frohro/Raspberry_Pi_Pico_MultiBoard/Hardware/Download_STEP_150505M173300_rev1.stp

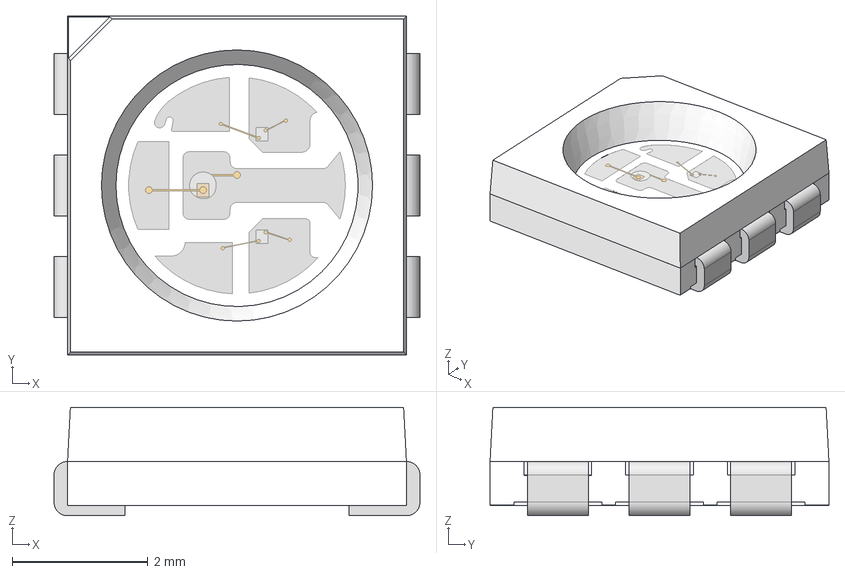
[picture p1: CAD file, 2025-04-10]
Hardware/Download_STEP_150505M173300_rev1.stp
5.40 x 5.00 x 1.60 mm
cover
housing
base x 2
