frohro/Raspberry_Pi_Pico_MultiBoard/Hardware/Amphenol RF 122404.STEP

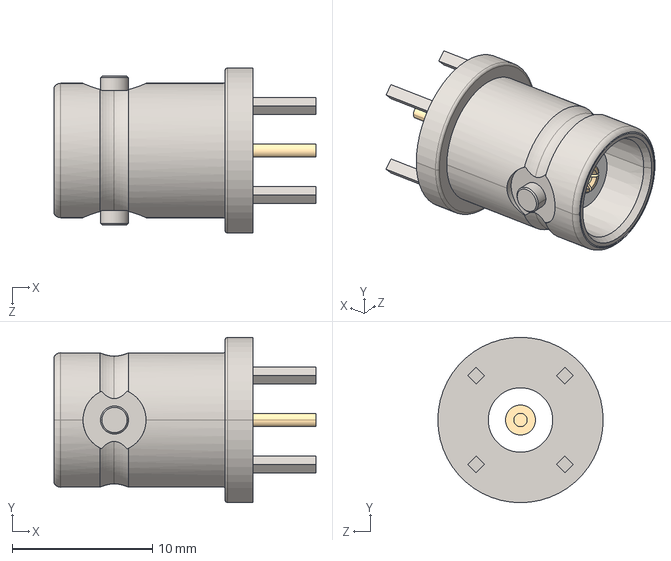
[picture p2: CAD file, 2025-04-10]
Hardware/Amphenol RF 122404.STEP
18.7 x 11.8 x 11.8 mm
