frohro/Raspberry_Pi_Pico_MultiBoard/Hardware/pj-326-1.snapshot.7/fix.FCStd

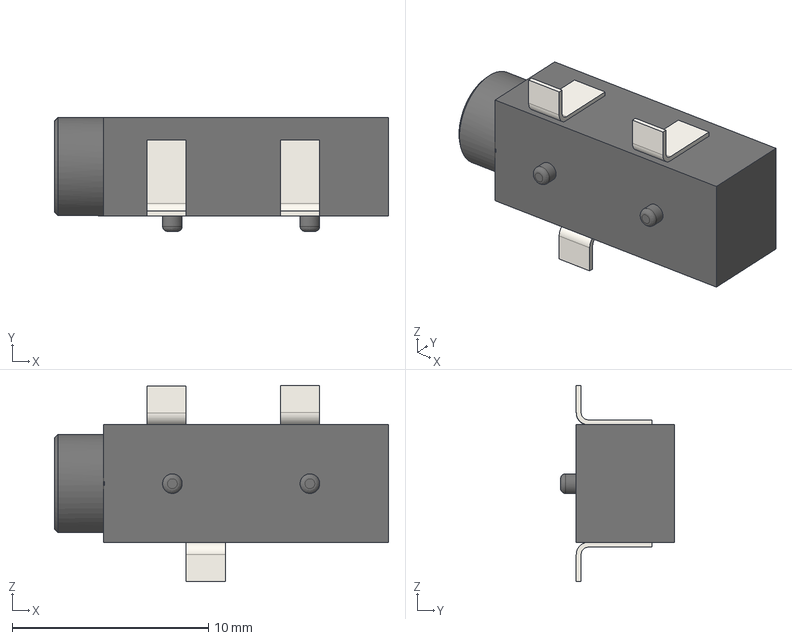
[picture p3: CAD file, 2025-04-10]
Hardware/pj-326-1.snapshot.7/fix.FCStd
17.0 x 5.80 x 9.98 mm
sj-3524-smt-tr-pi v1
sj-3524-smt-tr-pi v002
sj-3524-smt-tr-pi v003
sj-3524-smt-tr-pi v004
sj-3524-smt-tr-pi v005
sj-3524-smt-tr-pi v006
