frohro/Raspberry_Pi_Pico_MultiBoard/Hardware/Multiwatt15_V_STM.step

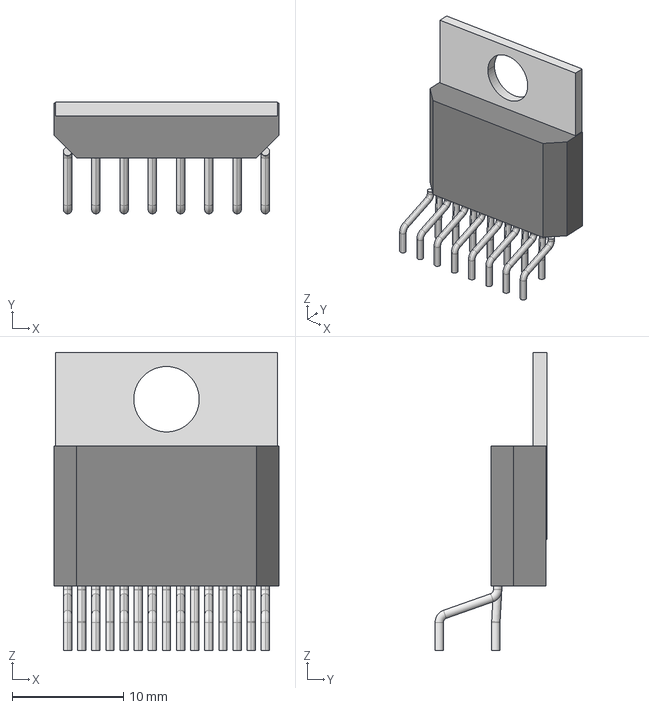
[picture p4: CAD file, 2025-04-10]
Hardware/Multiwatt15_V_STM.step
20.2 x 10.1 x 26.8 mm
