frohro/Raspberry_Pi_Pico_MultiBoard/Hardware/pj-326-1.snapshot.7/SJ-3523.step

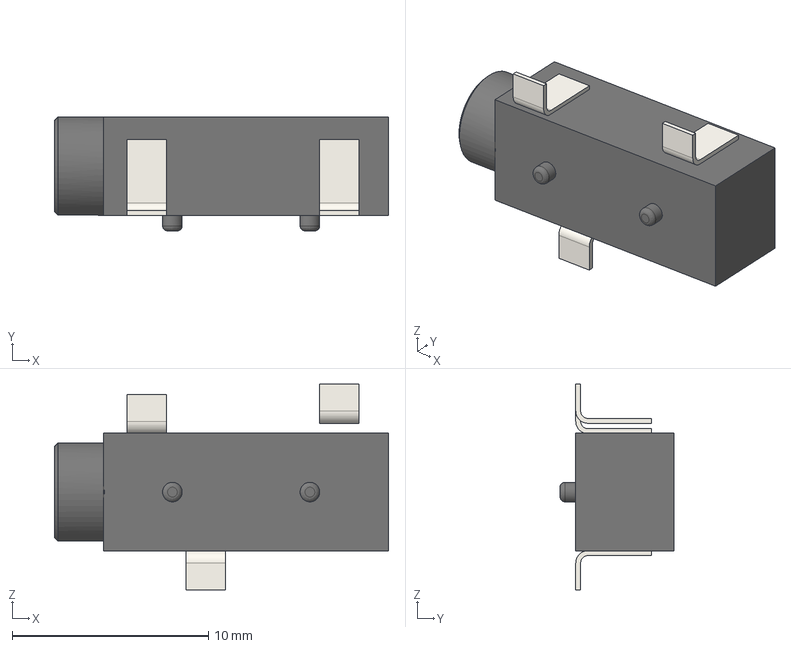
[picture p5: CAD file, 2025-04-10]
Hardware/pj-326-1.snapshot.7/SJ-3523.step
17.0 x 5.80 x 10.5 mm
sj-3524-smt-tr-pi v1 x 2
sj-3524-smt-tr-pi v002 x 2
sj-3524-smt-tr-pi v003 x 2
sj-3524-smt-tr-pi v004 x 2
