frohro/Raspberry_Pi_Pico_MultiBoard/Hardware/pj-326-1.snapshot.7/SJ-3523-sj-3524-smt-tr-pi v005.step

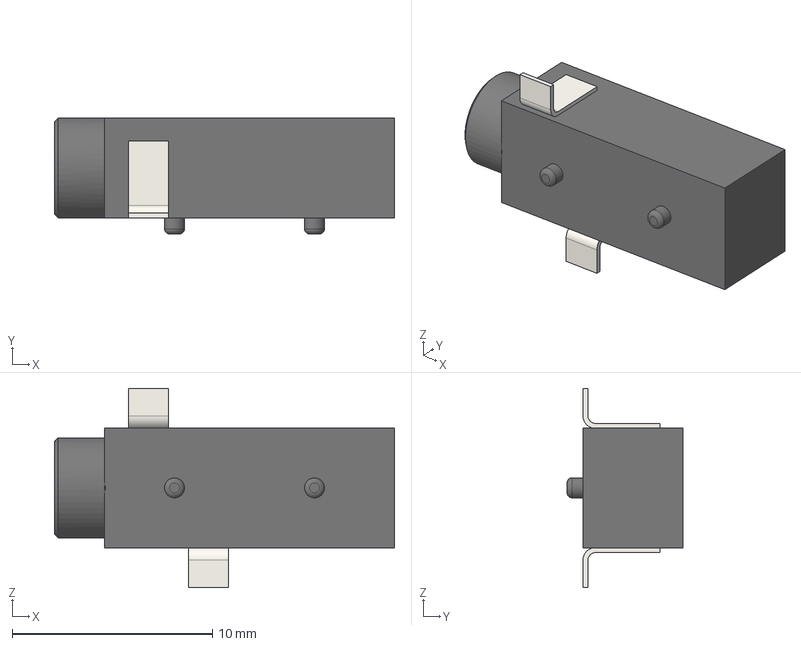
[picture p6: CAD file, 2025-04-10]
Hardware/pj-326-1.snapshot.7/SJ-3523-sj-3524-smt-tr-pi v005.step
17.0 x 5.80 x 9.96 mm
sj-3524-smt-tr-pi v1
sj-3524-smt-tr-pi v002
sj-3524-smt-tr-pi v004
