frohro/Raspberry_Pi_Pico_MultiBoard/Hardware/pj-326-1.snapshot.7/PJ-326.step

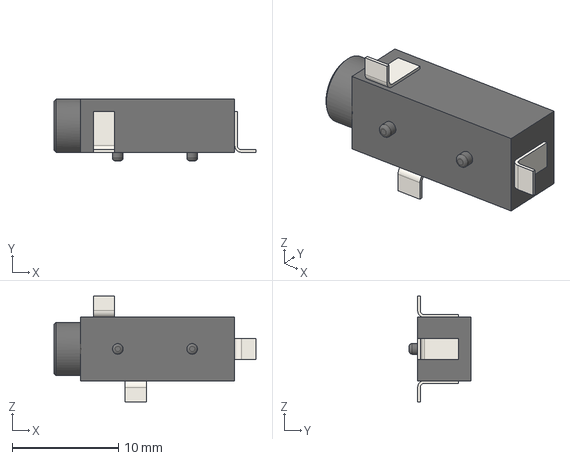
[picture p7: CAD file, 2025-04-10]
Hardware/pj-326-1.snapshot.7/PJ-326.step
19.0 x 5.80 x 9.96 mm
