frohro/Raspberry_Pi_Pico_MultiBoard/Hardware/pj-326-1.snapshot.7/SJ-3523-sj-3524-smt-tr-pi v005sj-3524-smt-tr-pi v003.step

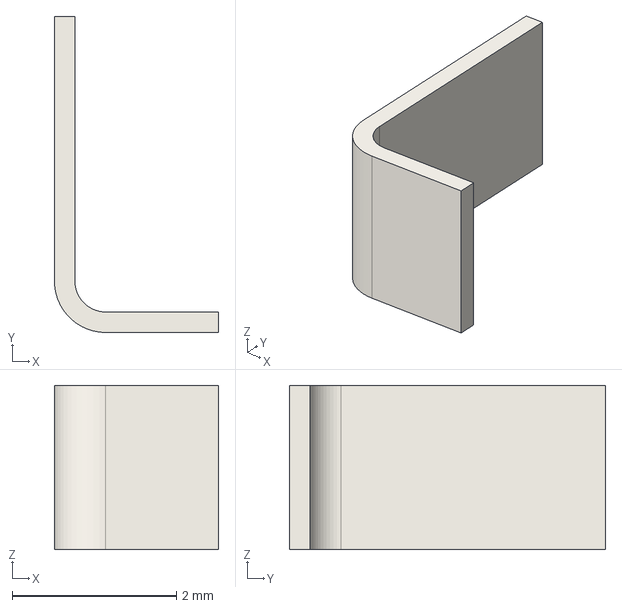
[picture p8: CAD file, 2025-04-10]
Hardware/pj-326-1.snapshot.7/SJ-3523-sj-3524-smt-tr-pi v005sj-3524-smt-tr-pi v003.step
2.00 x 3.85 x 2.00 mm
