frohro/Raspberry_Pi_Pico_MultiBoard/Hardware/Audio_in_usd_sound_rp_pico.pdf

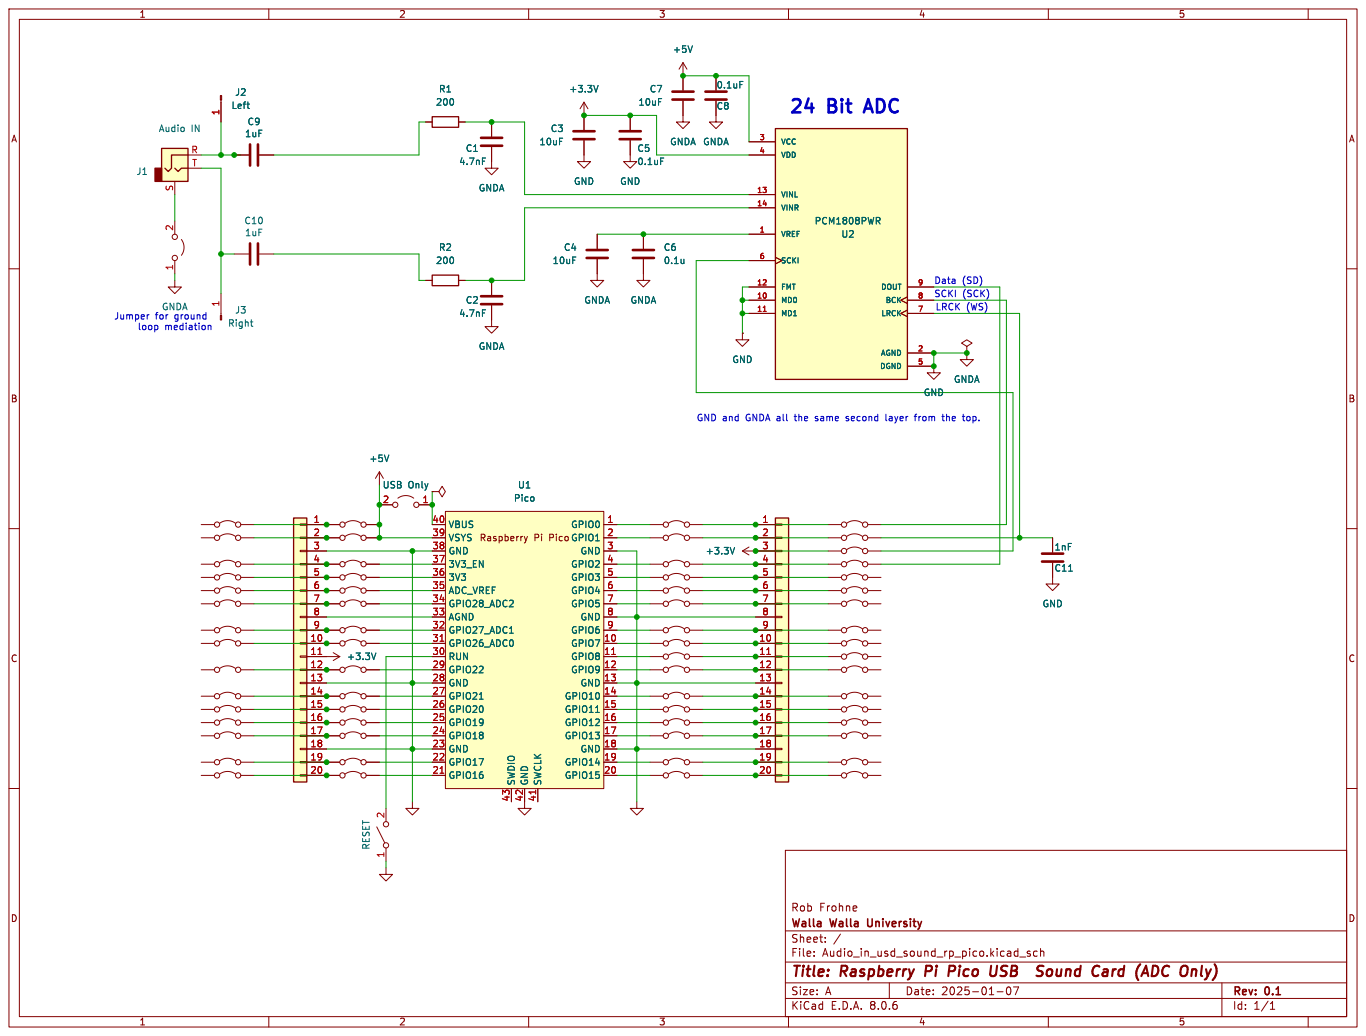
[picture p10: page 1]

GND and GNDA all the same second layer from the top. SCKI (SCK)
