frohro/Raspberry_Pi_Pico_MultiBoard/Hardware/Audio_in_usd_sound_rp_pico.kicad_pcb

## KiCad design Hardware/Audio_in_usd_sound_rp_pico.kicad_pcb (2025-04-10)

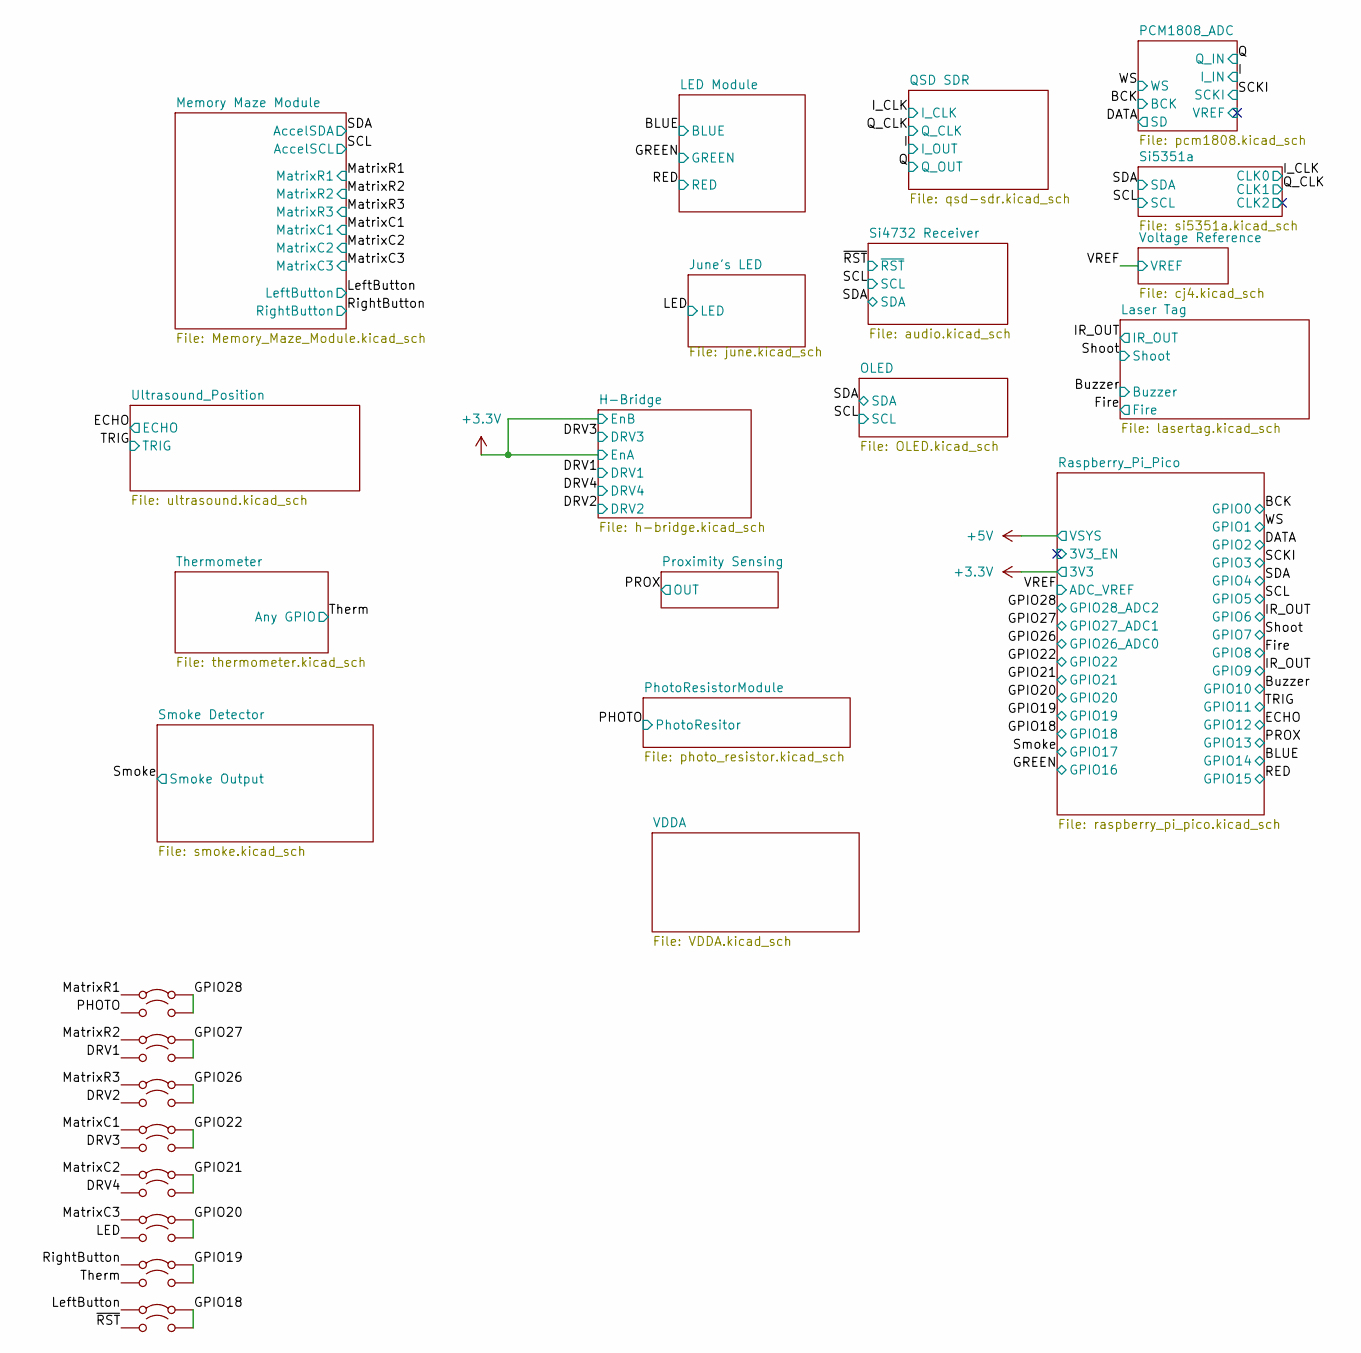
[picture p11: schematic Audio_in_usd_sound_rp_pico.kicad_sch, Raspberry Pi Pico USB Sound Card (ADC Only)]

Parts:
JP1, JP3, JP5, JP7, JP9, JP11, JP13, JP15: Jumper_2_Bridged; SolderJumper-2_P1.3mm_Bridged2Bar_RoundedPad1.0x1.5mm
JP2, JP4, JP6, JP8, JP10, JP12, JP14, JP16: Jumper_2_Open; SolderJumper-2_P1.3mm_Open_RoundedPad1.0x1.5mm

Connections:
/DRV1: JP4.1 (A); also elsewhere on the board
/DRV2: JP6.1 (A); also elsewhere on the board
/DRV3: JP8.1 (A); also elsewhere on the board
/DRV4: JP10.1 (A); also elsewhere on the board
/GPIO18: JP15.2 (B), JP16.2 (B); also elsewhere on the board
/GPIO19: JP13.2 (B), JP14.2 (B); also elsewhere on the board
/GPIO20: JP11.2 (B), JP12.2 (B); also elsewhere on the board
/GPIO21: JP9.2 (B), JP10.2 (B); also elsewhere on the board
/GPIO22: JP7.2 (B), JP8.2 (B); also elsewhere on the board
/GPIO26: JP5.2 (B), JP6.2 (B); also elsewhere on the board
/GPIO27: JP3.2 (B), JP4.2 (B); also elsewhere on the board
/GPIO28: JP1.2 (B), JP2.2 (B); also elsewhere on the board
/LED: JP12.1 (A); also elsewhere on the board
/LeftButton: JP15.1 (A); also elsewhere on the board
/MatrixC1: JP7.1 (A); also elsewhere on the board
/MatrixC2: JP9.1 (A); also elsewhere on the board
/MatrixC3: JP11.1 (A); also elsewhere on the board
/MatrixR1: JP1.1 (A); also elsewhere on the board
/MatrixR2: JP3.1 (A); also elsewhere on the board
/MatrixR3: JP5.1 (A); also elsewhere on the board
/PHOTO: JP2.1 (A); also elsewhere on the board
/RightButton: JP13.1 (A); also elsewhere on the board
/Therm: JP14.1 (A); also elsewhere on the board
/~RST: JP16.1 (A); also elsewhere on the board

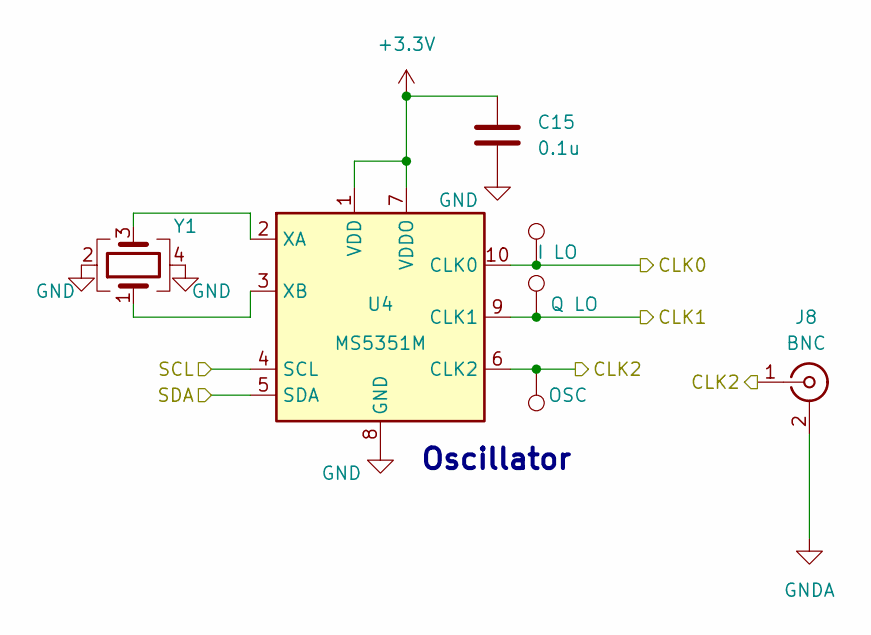
[picture p12: schematic si5351a.kicad_sch, Si5351a Module]

Parts:
C15: 0.1u; C_0805_2012Metric; LCSC C49678
J8: BNC; BNC_TEConnectivity_1478204_Vertical
TP3: I LO; TestPoint_THTPad_D1.0mm_Drill0.5mm
TP4: Q LO; TestPoint_THTPad_D1.0mm_Drill0.5mm
TP5: OSC; TestPoint_THTPad_D1.0mm_Drill0.5mm
U4: MS5351M; MSOP-10_3x3mm_P0.5mm; LCSC C1509083
Y1: X322525MSB4SI; Crystal_SMD_3225-4Pin_3.2x2.5mm; LCSC C9006

Connections:
+3.3V: C15.2, U4.1 (VDD), U4.7 (VDDO); also elsewhere on the board
/I_CLK: TP3.1, U4.10 (CLK0); also elsewhere on the board
/Q_CLK: TP4.1, U4.9 (CLK1); also elsewhere on the board
/SCL: U4.4 (SCL); also elsewhere on the board
/SDA: U4.5 (SDA); also elsewhere on the board
/Si5351a/CLK2: J8.1 (In), TP5.1, U4.6 (CLK2)
GND: C15.1, J8.2 (Ext), U4.8 (GND), Y1.2, Y1.4; also elsewhere on the board
unnamed: U4.2 (XA), Y1.3
unnamed: U4.3 (XB), Y1.1

Notes on the sheet:
Oscillator

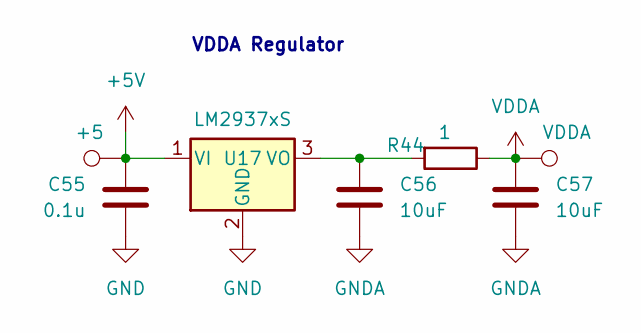
[picture p13: schematic VDDA.kicad_sch]

Parts:
C55: 0.1u; C_0805_2012Metric; LCSC C49678
C56, C57: 10uF; C_0805_2012Metric; LCSC C15850
R44: 1; R_0805_2012Metric; LCSC C25271
TP25: +5; TestPoint_THTPad_D1.0mm_Drill0.5mm
TP26: VDDA; TestPoint_THTPad_D1.0mm_Drill0.5mm
U17: LM2937xS; TO-263-3_TabPin2; LCSC C2902486

Connections:
+5V: C55.1, TP25.1, U17.1 (VI); also elsewhere on the board
GND: C55.2, C56.2, C57.2, U17.2 (GND); also elsewhere on the board
unnamed: C56.1, R44.2, U17.3 (VO)
VDDA: C57.1, R44.1, TP26.1; also elsewhere on the board

Notes on the sheet:
VDDA Regulator

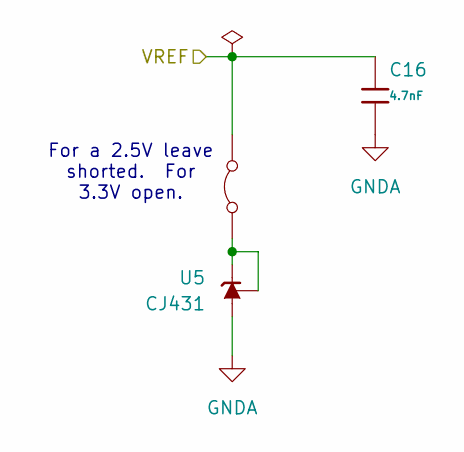
[picture p14: schematic cj4.kicad_sch]

Parts:
C16: 4.7nF; C_0805; Voltage Rated 50V; Tolerance ±10%; Part 0805B472K500NT; LCSC C1744
JP84: Jumper_2_Bridged; SolderJumper-2_P1.3mm_Bridged2Bar_RoundedPad1.0x1.5mm
U5: CJ431; SOT-23; JLCPCB Rotation Offset 180

Connections:
/VREF: C16.1, JP84.2 (B); also elsewhere on the board
GND: C16.2, U5.3 (A); also elsewhere on the board
unnamed: JP84.1 (A), U5.1 (REF), U5.2 (K)

Notes on the sheet:
For a 2.5V leave shorted. For 3.3V open.

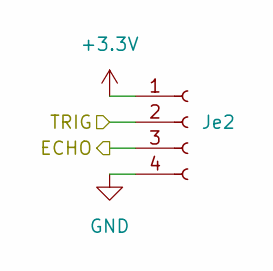
[picture p15: schematic ultrasound.kicad_sch]

Parts:
Je2: Conn_01x04_Socket; PinHeader_1x04_P2.54mm_Vertical_Female; LCSC C2718488

Connections:
+3.3V: Je2.1; also elsewhere on the board
/ECHO: Je2.3; also elsewhere on the board
/TRIG: Je2.2; also elsewhere on the board
GND: Je2.4; also elsewhere on the board

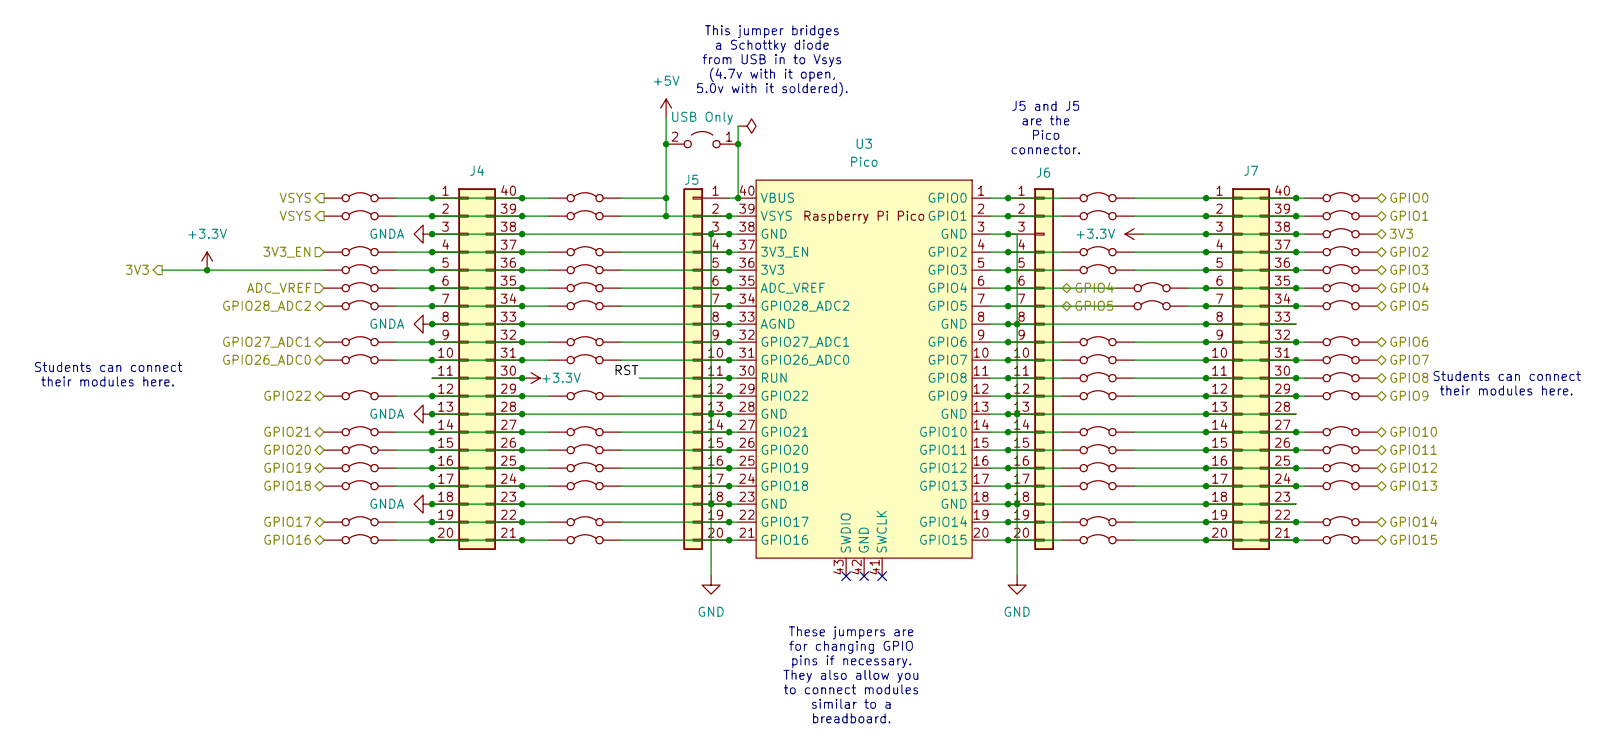
[picture p16: schematic raspberry_pi_pico.kicad_sch]

Parts:
J4: Conn_02x20_Counter_Clockwise; PinSocket_2x20_P2.54mm_Vertical_Counterclockwise; LCSC C2977589
J5, J6: Conn_01x20; PinHeader_1x20_P2.54mm_Vertical; LCSC C2905423
J7: Conn_02x20_Counter_Clockwise; PinSocket_2x20_P2.54mm_Vertical; LCSC C2977589
JP20, JP21, JP22, JP23, JP24, JP25, JP26, JP27, JP28, JP29, JP30, JP31, JP32, JP33, JP34, JP35, JP36, JP37, JP38, JP39, JP40, JP41, JP42, JP43, JP44, JP45, JP46, JP47, JP48, JP49, JP51, JP52, JP53, JP54, JP55, JP56, JP57, JP58, JP59, JP60, JP61, JP62, JP63, JP64, JP65, JP66, JP67, JP68, JP69, JP70, JP71, JP72, JP73, JP74, JP75, JP76, JP77, JP78, JP79, JP80, JP81, JP82, JP83: Jumper_2_Bridged; SolderJumper-2_P1.3mm_Bridged2Bar_RoundedPad1.0x1.5mm
JP50: USB Only; SolderJumper-2_P1.3mm_Open_RoundedPad1.0x1.5mm
U3: Pico; RPi_Pico_SMD_TH

Connections:
+3.3V: J4.11, J4.30, J7.3, J7.38, JP23.1 (A), JP69.1 (A), JP69.2 (B); also elsewhere on the board
+5V: J5.2, JP20.1 (A), JP21.1 (A), JP35.2 (B), JP36.2 (B), JP50.2 (B), U3.39 (VSYS); also elsewhere on the board
/BCK: JP67.2 (B); also elsewhere on the board
/BLUE: JP82.2 (B); also elsewhere on the board
/Buzzer: JP78.2 (B); also elsewhere on the board
/DATA: JP70.2 (B); also elsewhere on the board
/ECHO: JP80.2 (B); also elsewhere on the board
/Fire: JP76.2 (B); also elsewhere on the board
/GPIO18: JP32.1 (A); also elsewhere on the board
/GPIO19: JP31.1 (A); also elsewhere on the board
/GPIO20: JP30.1 (A); also elsewhere on the board
/GPIO21: JP29.1 (A); also elsewhere on the board
/GPIO22: JP28.1 (A); also elsewhere on the board
/GPIO26: JP27.1 (A); also elsewhere on the board
/GPIO27: JP26.1 (A); also elsewhere on the board
/GPIO28: JP25.1 (A); also elsewhere on the board
/GREEN: JP34.1 (A); also elsewhere on the board
/IR_OUT: JP74.2 (B), JP77.2 (B); also elsewhere on the board
/PROX: JP81.2 (B); also elsewhere on the board
/RED: JP83.2 (B); also elsewhere on the board
/Raspberry_Pi_Pico/3V3_EN: JP22.1 (A)
/Raspberry_Pi_Pico/RST: J5.11, U3.30 (RUN)
/SCKI: JP71.2 (B); also elsewhere on the board
/SCL: J6.7, JP56.1 (A), JP73.2 (B), U3.7 (GPIO5); also elsewhere on the board
/SDA: J6.6, JP55.1 (A), JP72.2 (B), U3.6 (GPIO4); also elsewhere on the board
/Shoot: JP75.2 (B); also elsewhere on the board
/Smoke: JP33.1 (A); also elsewhere on the board
/TRIG: JP79.2 (B); also elsewhere on the board
/VREF: JP24.1 (A); also elsewhere on the board
/WS: JP68.2 (B); also elsewhere on the board
GND: J4.3, J4.8, J4.13, J4.18, J4.23, J4.28, J4.33, J4.38, J5.3, J5.8, J5.13, J5.18, J6.3, J6.8, J6.13, J6.18, J7.8, J7.13, J7.18, J7.23, J7.28, J7.33, U3.3 (GND), U3.8 (GND), U3.13 (GND), U3.18 (GND), U3.23 (GND), U3.28 (GND), U3.33 (AGND), U3.38 (GND); also elsewhere on the board
unnamed: J4.1, J4.40, JP20.2 (B), JP35.1 (A)
unnamed: J4.2, J4.39, JP21.2 (B), JP36.1 (A)
unnamed: J4.10, J4.31, JP27.2 (B), JP42.1 (A)
unnamed: J4.12, J4.29, JP28.2 (B), JP43.1 (A)
unnamed: J4.14, J4.27, JP29.2 (B), JP44.1 (A)
unnamed: J4.15, J4.26, JP30.2 (B), JP45.1 (A)
unnamed: J4.16, J4.25, JP31.2 (B), JP46.1 (A)
unnamed: J4.17, J4.24, JP32.2 (B), JP47.1 (A)
unnamed: J4.19, J4.22, JP33.2 (B), JP48.1 (A)
unnamed: J4.20, J4.21, JP34.2 (B), JP49.1 (A)
unnamed: J4.9, J4.32, JP26.2 (B), JP41.1 (A)
unnamed: J4.7, J4.34, JP25.2 (B), JP40.1 (A)
unnamed: J4.6, J4.35, JP24.2 (B), JP39.1 (A)
unnamed: J4.5, J4.36, JP23.2 (B), JP38.1 (A)
unnamed: J4.4, J4.37, JP22.2 (B), JP37.1 (A)
unnamed: J5.1, JP50.1 (A), U3.40 (VBUS)
unnamed: J5.4, JP37.2 (B), U3.37 (3V3_EN)
unnamed: J5.5, JP38.2 (B), U3.36 (3V3)
unnamed: J5.6, JP39.2 (B), U3.35 (ADC_VREF)
unnamed: J5.7, JP40.2 (B), U3.34 (GPIO28_ADC2)
unnamed: J5.9, JP41.2 (B), U3.32 (GPIO27_ADC1)
unnamed: J5.10, JP42.2 (B), U3.31 (GPIO26_ADC0)
unnamed: J5.12, JP43.2 (B), U3.29 (GPIO22)
unnamed: J5.14, JP44.2 (B), U3.27 (GPIO21)
unnamed: J5.15, JP45.2 (B), U3.26 (GPIO20)
unnamed: J5.16, JP46.2 (B), U3.25 (GPIO19)
unnamed: J5.17, JP47.2 (B), U3.24 (GPIO18)
unnamed: J5.19, JP48.2 (B), U3.22 (GPIO17)
unnamed: J5.20, JP49.2 (B), U3.21 (GPIO16)
unnamed: J6.1, JP51.1 (A), U3.1 (GPIO0)
unnamed: J6.2, JP52.1 (A), U3.2 (GPIO1)
unnamed: J6.4, JP53.1 (A), U3.4 (GPIO2)
unnamed: J6.5, JP54.1 (A), U3.5 (GPIO3)
unnamed: J6.9, JP57.1 (A), U3.9 (GPIO6)
unnamed: J6.10, JP58.1 (A), U3.10 (GPIO7)
unnamed: J6.11, JP59.1 (A), U3.11 (GPIO8)
unnamed: J6.12, JP60.1 (A), U3.12 (GPIO9)
unnamed: J6.14, JP61.1 (A), U3.14 (GPIO10)
unnamed: J6.15, JP62.1 (A), U3.15 (GPIO11)
unnamed: J6.16, JP63.1 (A), U3.16 (GPIO12)
unnamed: J6.17, JP64.1 (A), U3.17 (GPIO13)
unnamed: J6.19, JP65.1 (A), U3.19 (GPIO14)
unnamed: J6.20, JP66.1 (A), U3.20 (GPIO15)
unnamed: J7.1, J7.40, JP51.2 (B), JP67.1 (A)
unnamed: J7.2, J7.39, JP52.2 (B), JP68.1 (A)
unnamed: J7.10, J7.31, JP58.2 (B), JP75.1 (A)
unnamed: J7.11, J7.30, JP59.2 (B), JP76.1 (A)
unnamed: J7.12, J7.29, JP60.2 (B), JP77.1 (A)
unnamed: J7.14, J7.27, JP61.2 (B), JP78.1 (A)
unnamed: J7.15, J7.26, JP62.2 (B), JP79.1 (A)
unnamed: J7.16, J7.25, JP63.2 (B), JP80.1 (A)
unnamed: J7.17, J7.24, JP64.2 (B), JP81.1 (A)
unnamed: J7.19, J7.22, JP65.2 (B), JP82.1 (A)
unnamed: J7.20, J7.21, JP66.2 (B), JP83.1 (A)
unnamed: J7.9, J7.32, JP57.2 (B), JP74.1 (A)
unnamed: J7.7, J7.34, JP56.2 (B), JP73.1 (A)
unnamed: J7.6, J7.35, JP55.2 (B), JP72.1 (A)
unnamed: J7.5, J7.36, JP54.2 (B), JP71.1 (A)
unnamed: J7.4, J7.37, JP53.2 (B), JP70.1 (A)

Notes on the sheet:
These jumpers are for changing GPIO pins if necessary. They also allow you to connect modules similar to a breadboard.
Students can connect their modules here.
J5 and J5 are the Pico connector.
This jumper bridges a Schottky diode from USB in to Vsys (4.7v with it open, 5.0v with it soldered).

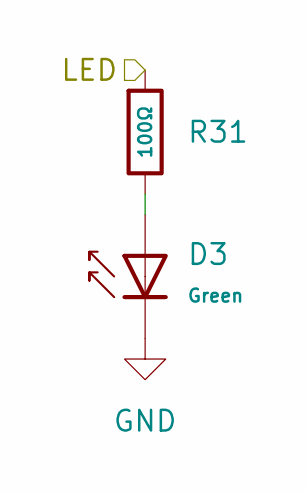
[picture p17: schematic june.kicad_sch]

Parts:
D3: Green; D_0805; Part KT-0805G; LCSC C2297
R31: 100Ω; R_0805; Overload Voltage (Max) 150V; Tolerance ±1%; Part 0805W8F1000T5E; LCSC C17408

Connections:
/LED: R31.1; also elsewhere on the board
GND: D3.1; also elsewhere on the board
unnamed: D3.2, R31.2

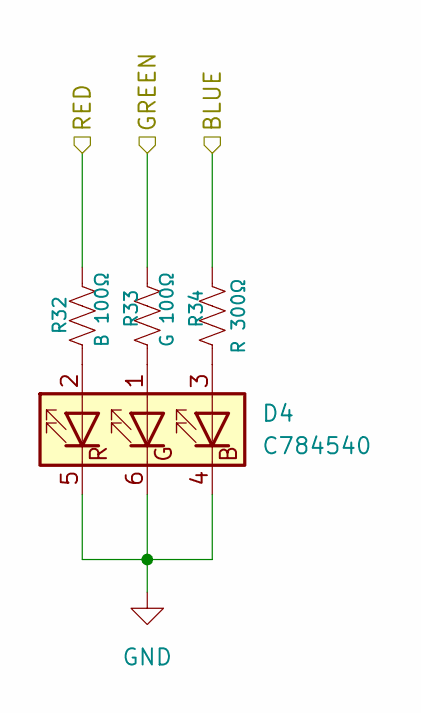
[picture p18: schematic LEDmodule.kicad_sch]

Parts:
D4: C784540; LED footprint; LCSC C784540
R32: B 100Ω; L_0805_2012Metric; JLCPCB# C25277
R33: G 100Ω; L_0805_2012Metric; JLCPCB# C25277
R34: R 300Ω; R_0805_2012Metric; JLCPCB# C168494

Connections:
/BLUE: R34.1; also elsewhere on the board
/GREEN: R33.1; also elsewhere on the board
/RED: R32.1; also elsewhere on the board
GND: D4.4 (BK), D4.5 (RK), D4.6 (GK); also elsewhere on the board
unnamed: D4.3 (BA), R34.2
unnamed: D4.1 (GA), R33.2
unnamed: D4.2 (RA), R32.2

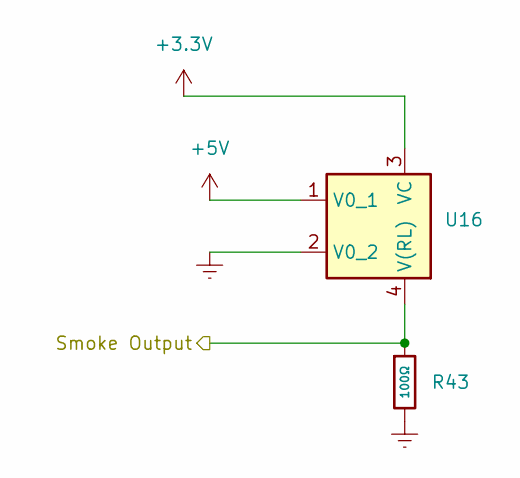
[picture p19: schematic smoke.kicad_sch]

Parts:
R43: 100Ω; R_0805; Overload Voltage (Max) 150V; Tolerance ±1%; Part 0805W8F1000T5E; LCSC C17408
U16: TO-33-4_Window-Taylan; LCSC C5380082

Connections:
+3.3V: U16.3 (VC); also elsewhere on the board
+5V: U16.1 (V0_1); also elsewhere on the board
/Smoke: R43.1, U16.4 (V(RL)); also elsewhere on the board
<NO NET>: R43.2, U16.2 (V0_2)

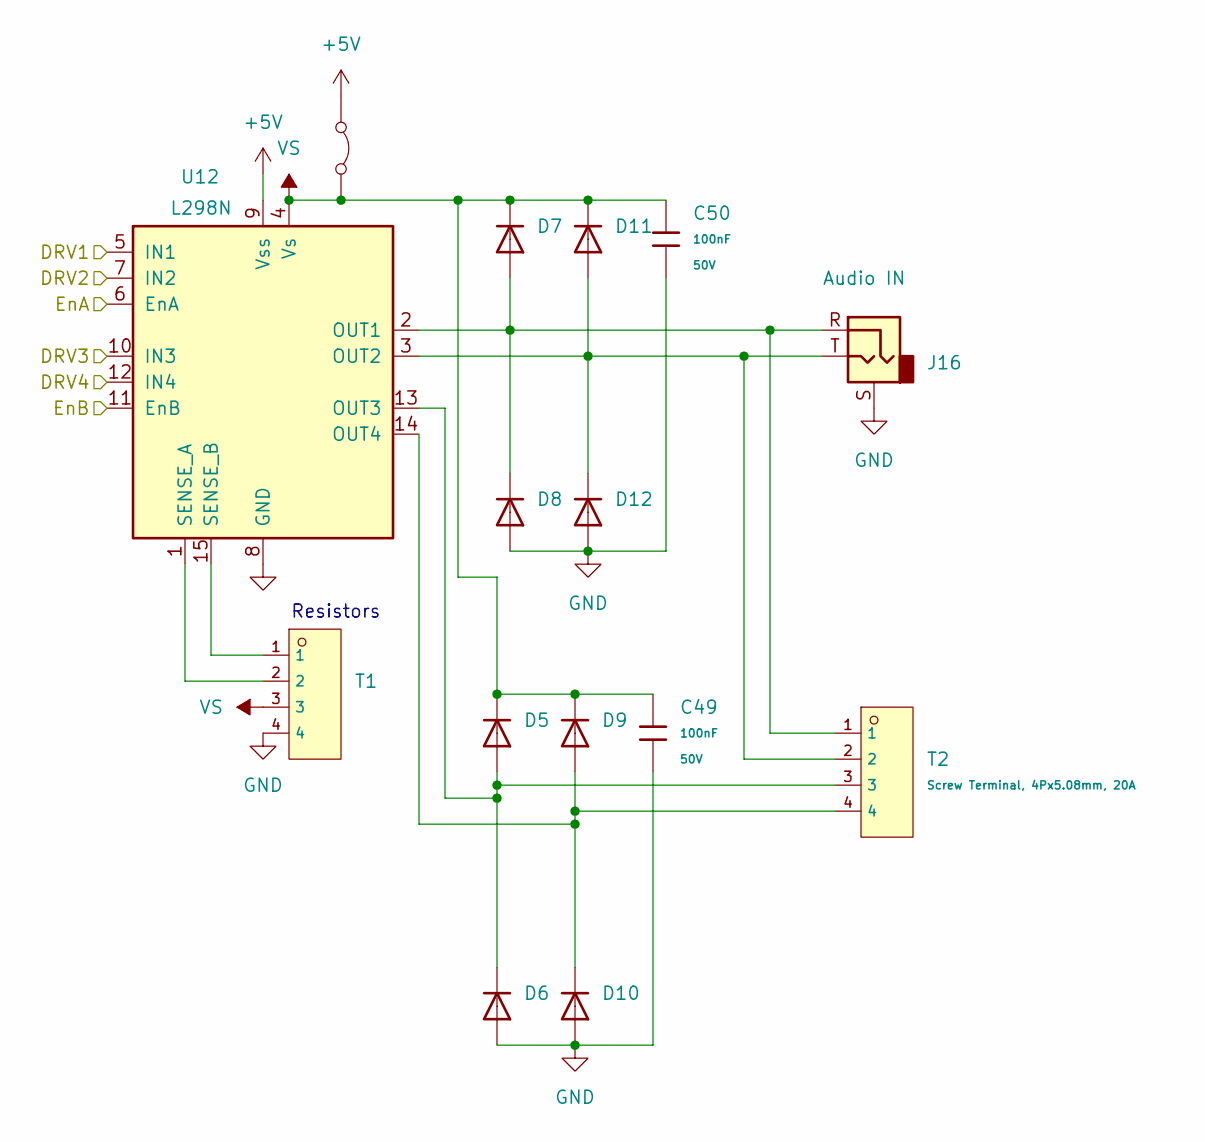
[picture p20: schematic h-bridge.kicad_sch]

Parts:
C49, C50: 100nF; C_0805; Voltage Rated 50V; Tolerance ±10%; Part CC0805KRX7R9BB104; LCSC C49678
D5, D6, D7, D8, D9, D10, D11, D12: 1N4004W; D_SOD-123FL; Forward Voltage (Vf@If) 1V@1.0A; Reverse Voltage (Vr) 400V; Part 1N4004W; LCSC C18199087
J16: Audio IN; Jack_3.5mm_CUI_SJ-3523-SMT_Horizontal; LCSC C18594
JP89: Jumper_2_Bridged; SolderJumper-2_P1.3mm_Bridged2Bar_RoundedPad1.0x1.5mm
T1, T2: Screw Terminal, 4Px5.08mm, 20A; CONN-TH_4P-P5.08_DB129VG-5.08-4P-GN-S; Current Rating (Max) 20A; Voltage Rating (Max) 300V; Part DB129VG-5.08-4P-GN-S; LCSC C2981774
U12: L298N; TO-220-15_P2.54x2.54mm_StaggerOdd_Lead4.58mm_Vertical; JLCPCB part # C19922

Connections:
+3.3V: U12.6 (EnA), U12.11 (EnB); also elsewhere on the board
+5V: JP89.1 (A), U12.9 (Vss); also elsewhere on the board
/DRV1: U12.5 (IN1); also elsewhere on the board
/DRV2: U12.7 (IN2); also elsewhere on the board
/DRV3: U12.10 (IN3); also elsewhere on the board
/DRV4: U12.12 (IN4); also elsewhere on the board
GND: C49.2, C50.2, D6.2, D8.2, D10.2, D12.2, J16.S, T1.4, U12.8 (GND); also elsewhere on the board
unnamed: D7.2, D8.1, J16.R, T2.1, U12.2 (OUT1)
unnamed: D11.2, D12.1, J16.T, T2.2, U12.3 (OUT2)
unnamed: D5.2, D6.1, T2.3, U12.13 (OUT3)
unnamed: D9.2, D10.1, T2.4, U12.14 (OUT4)
unnamed: T1.2, U12.1 (SENSE_A)
unnamed: T1.1, U12.15 (SENSE_B)
VS: C49.1, C50.1, D5.1, D7.1, D9.1, D11.1, JP89.2 (B), T1.3, U12.4 (Vs)

Notes on the sheet:
Resistors

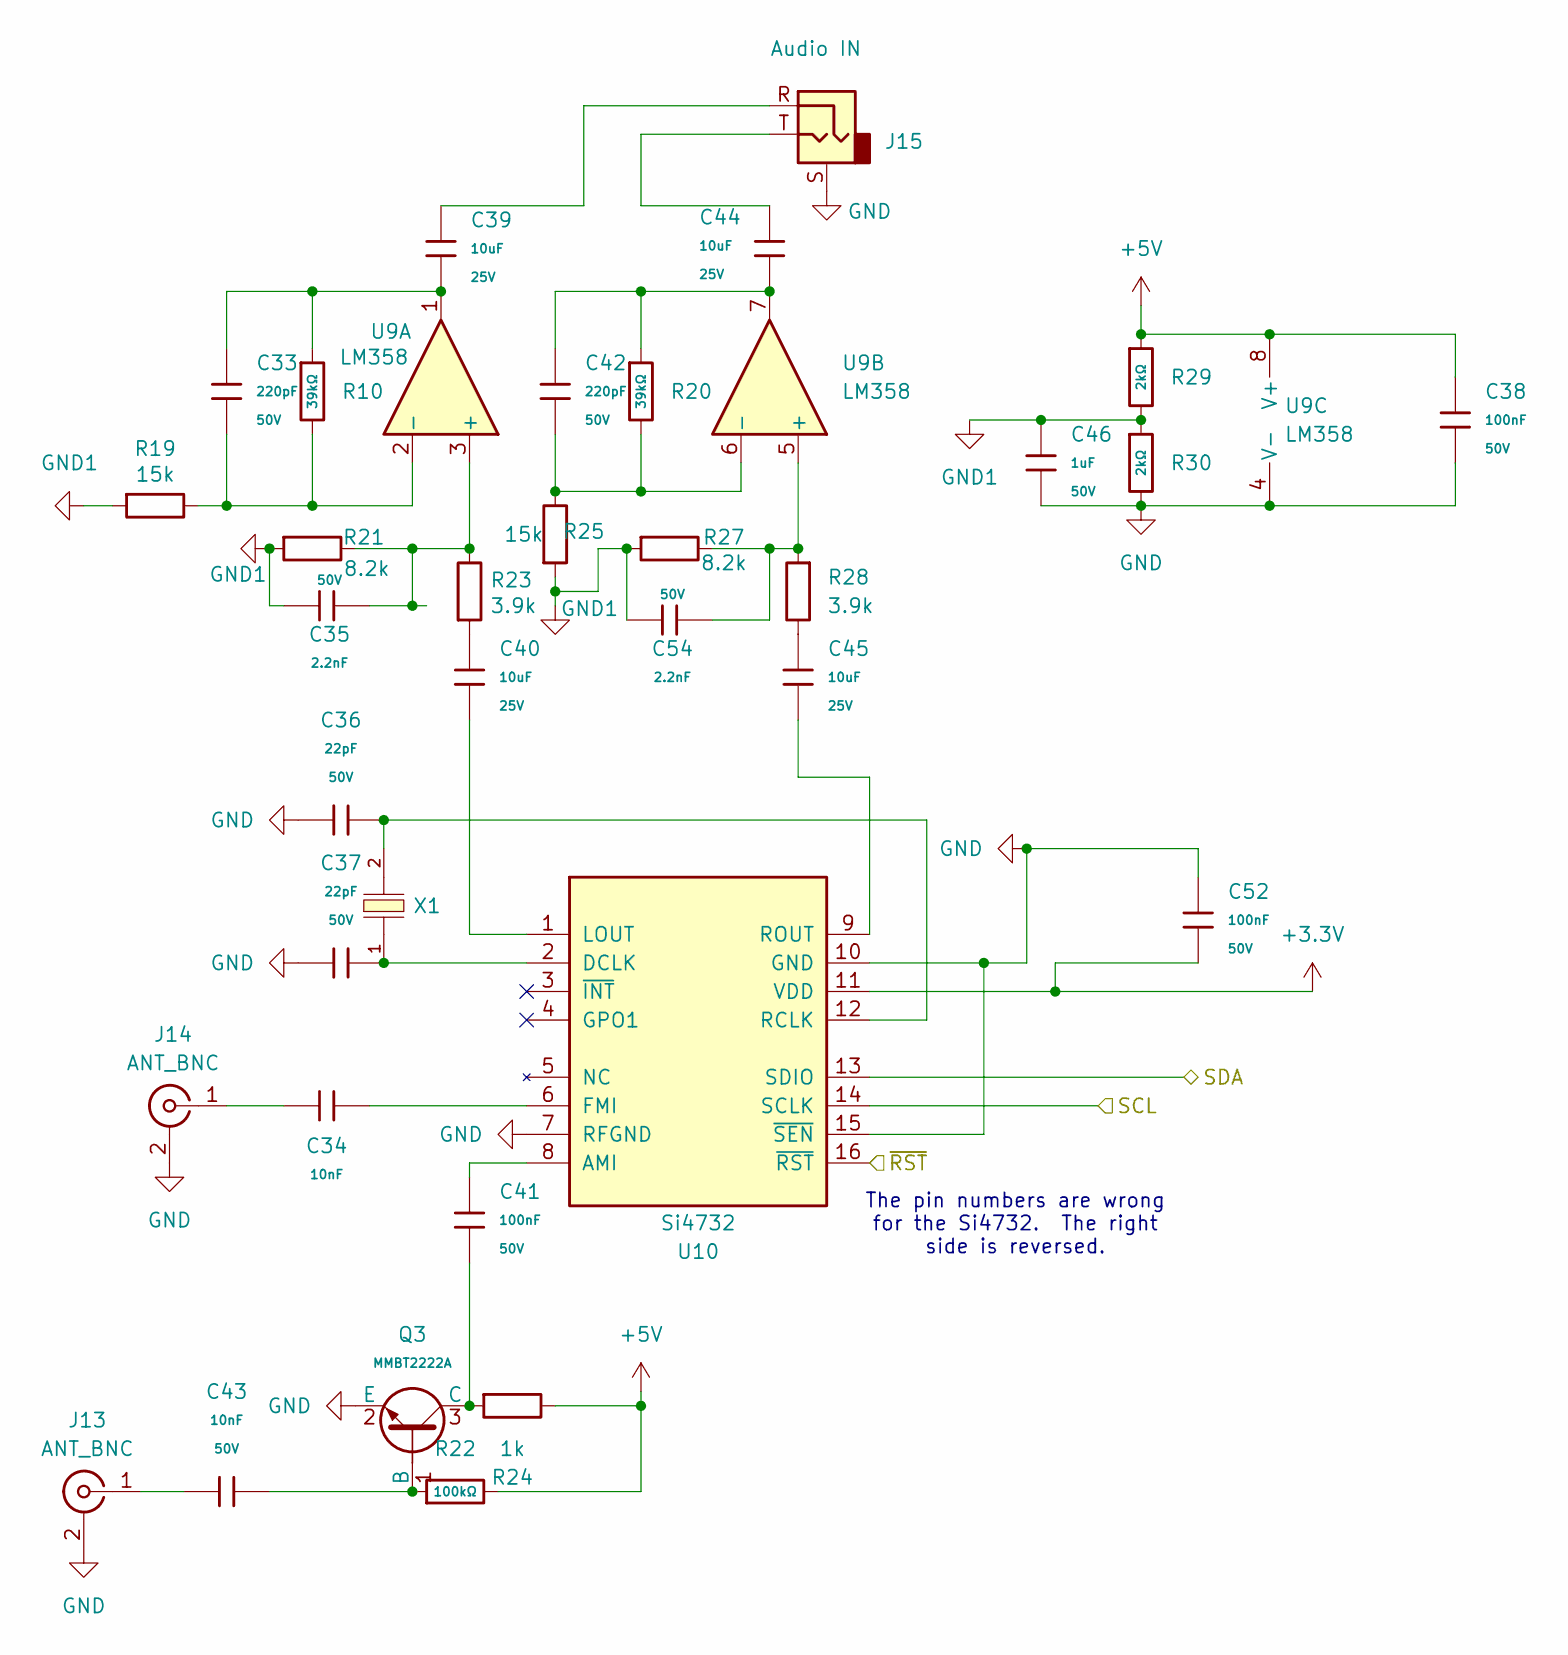
[picture p21: schematic audio.kicad_sch]

Parts:
C33, C42: 220pF; C_0805; Voltage Rated 50V; Tolerance ±10%; Part CC0805KRX7R9BB221; LCSC C107145
C34, C43: 10nF; C_0603; Voltage Rated 50V; Tolerance ±10%; Part 0603B103K500NT; LCSC C57112
C35, C54: 2.2nF; C_0603; Voltage Rated 50V; Tolerance ±10%; Part 0603B222K500NT; LCSC C1604
C36, C37: 22pF; C_0603; Voltage Rated 50V; Tolerance ±5%; Part CL10C220JB8NNNC; LCSC C1653
C38, C41, C52: 100nF; C_0603; Voltage Rated 50V; Tolerance ±10%; Part CC0603KRX7R9BB104; LCSC C14663
C39, C40, C44, C45: 10uF; C_0805; Voltage Rated 25V; Tolerance ±10%; Part CL21A106KAYNNNE; LCSC C15850
C46: 1uF; C_0805; Voltage Rated 50V; Tolerance ±10%; Part CL21B105KBFNNNE; LCSC C28323
J13, J14: ANT_BNC; BNC_TEConnectivity_1478204_Vertical
J15: Audio IN; Jack_3.5mm_CUI_SJ-3523-SMT_Horizontal; LCSC C18594
Q3: MMBT2222A; Q_SOT-23; Part MMBT2222A; LCSC C7420351
R10, R20: 39kΩ; R_0603; Overload Voltage (Max) 75V; Tolerance ±1%; Part 0603WAF3902T5E; LCSC C23153
R19, R25: 15k; R_0805_2012Metric; LCSC C17475
R21, R27: 8.2k; R_0805_2012Metric; LCSC C17828
R22: 100kΩ; R_0603; Overload Voltage (Max) 75V; Tolerance ±1%; Part 0603WAF1003T5E; LCSC C25803
R23, R28: 3.9k; R_0805_2012Metric; LCSC C17614
R24: 1k; R_1206_3216Metric; LCSC C4410
R29, R30: 2kΩ; R_0805; Overload Voltage (Max) 150V; Tolerance ±1%; Part 0805W8F2001T5E; LCSC C17604
U9: LM358; SOP-8_3.9x4.9mm_P1.27mm
U10: Si4732; SOIC-16_3.9x9.9mm_P1.27mm; LCSC C2155558
X1: Q13FC1350000400; FC-135R_L3.2-W1.5; Frequency Tolerance ±20ppm; Part Q13FC13500004; LCSC C32346

Connections:
+3.3V: C52.2, U10.11 (VDD); also elsewhere on the board
+5V: C38.1, R22.2, R24.1, R29.1, U9.8 (V+); also elsewhere on the board
/SCL: U10.14 (SCLK); also elsewhere on the board
/SDA: U10.13 (SDIO); also elsewhere on the board
/~RST: U10.16 (~RST); also elsewhere on the board
GND: C36.1, C37.2, C38.2, C46.2, C52.1, J13.2 (Ext), J14.2 (Ext), J15.S, Q3.2 (E), R30.2, U9.4 (V-), U10.7 (RFGND), U10.10 (GND), U10.15 (~SEN); also elsewhere on the board
GND1: C35.2, C46.1, C54.2, R19.2, R21.2, R25.2, R27.2, R29.2, R30.1
unnamed: C33.1, C39.2, R10.1, U9.1
unnamed: C39.1, J15.R
unnamed: C40.1, R23.2
unnamed: C42.1, C44.2, R20.1, U9.7
unnamed: C44.1, J15.T
unnamed: C45.1, R28.1
unnamed: C43.1, J13.1 (In)
unnamed: C34.1, J14.1 (In)
unnamed: C43.2, Q3.1 (B), R22.1
unnamed: C41.2, Q3.3 (C), R24.2
unnamed: C35.1, R21.1, R23.1, U9.3 (+)
unnamed: C33.2, R10.2, R19.1, U9.2 (-)
unnamed: C54.1, R27.1, R28.2, U9.5 (+)
unnamed: C42.2, R20.2, R25.1, U9.6 (-)
unnamed: C41.1, U10.8 (AMI)
unnamed: C37.1, U10.2 (DCLK), X1.1
unnamed: C34.2, U10.6 (FMI)
unnamed: C40.2, U10.1 (LOUT)
unnamed: C36.2, U10.12 (RCLK), X1.2
unnamed: C45.2, U10.9 (ROUT)

Notes on the sheet:
The pin numbers are wrong for the Si4732. The right side is reversed.

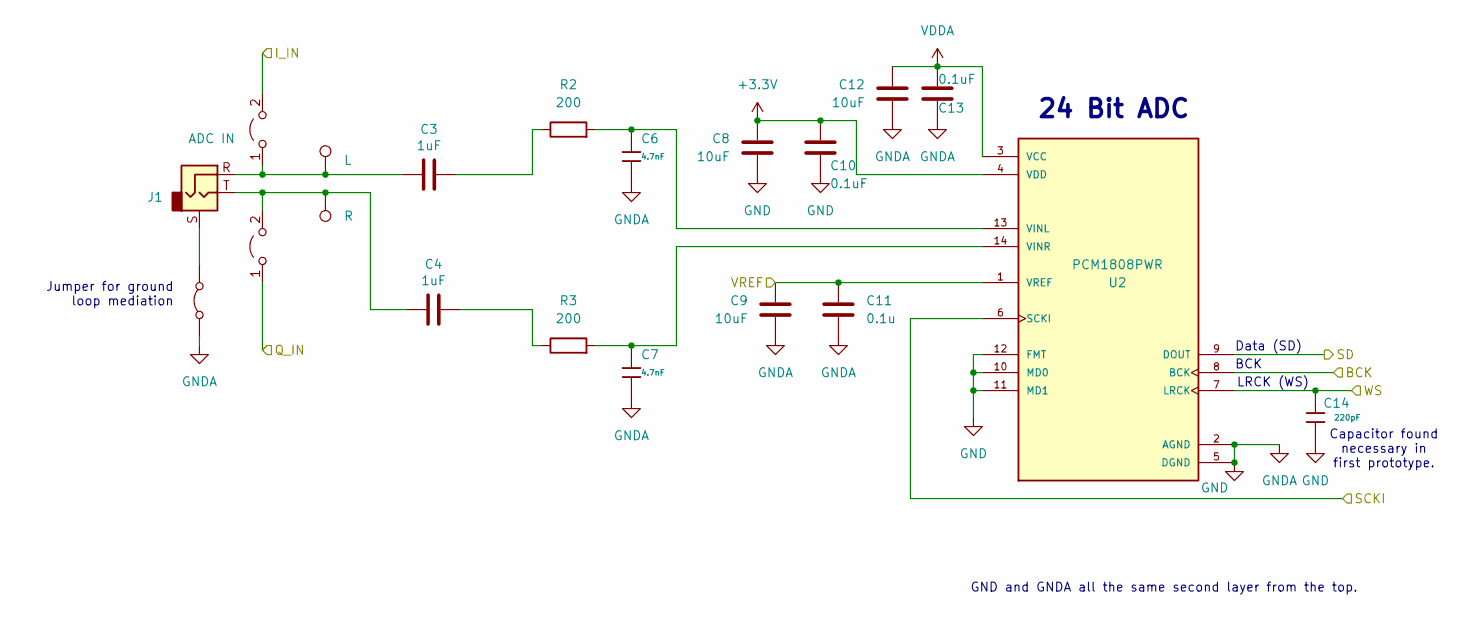
[picture p22: schematic pcm1808.kicad_sch, PCM1808 24 BIT ADC]

Parts:
C3, C4: 1uF; C_0805_2012Metric; LCSC C28323
C6, C7: 4.7nF; C_0805; Voltage Rated 50V; Tolerance ±10%; Part 0805B472K500NT; LCSC C1744
C8, C9, C12: 10uF; C_0805_2012Metric; LCSC C15850
C10, C13: 0.1uF; C_0805_2012Metric; LCSC C49678
C11: 0.1u; C_0805_2012Metric; LCSC C49678
C14: 220pF; C_0805; Voltage Rated 50V; Tolerance ±10%; Part CC0805KRX7R9BB221; LCSC C107145
J1: ADC IN; Jack_3.5mm_CUI_SJ-3523-SMT_Horizontal; LCSC C18594
JP17: Jumper_2_Bridged; SolderJumper-2_P1.3mm_Bridged2Bar_RoundedPad1.0x1.5mm
JP18, JP19: GND_LP_SND; SolderJumper-2_P1.3mm_Open_RoundedPad1.0x1.5mm
R2, R3: 200; R_0805_2012Metric; LCSC C17544
TP1: L; TestPoint_THTPad_D1.0mm_Drill0.5mm
TP2: R; TestPoint_THTPad_D1.0mm_Drill0.5mm
U2: PCM1808PWR; TSSOP-14_4.4x5mm_P0.65mm; PARTREV B; LCSC C55513

Connections:
+3.3V: C8.1, C10.2, U2.4 (VDD); also elsewhere on the board
/BCK: U2.8 (BCK); also elsewhere on the board
/DATA: U2.9 (DOUT); also elsewhere on the board
/I: JP18.2 (B); also elsewhere on the board
/PCM1808_ADC/VREF: C9.1, C11.2, U2.1 (VREF)
/Q: JP19.1 (A); also elsewhere on the board
/SCKI: U2.6 (SCKI); also elsewhere on the board
/WS: C14.1, U2.7 (LRCK); also elsewhere on the board
GND: C6.2, C7.2, C8.2, C9.2, C10.1, C11.1, C12.2, C13.1, C14.2, JP17.1 (A), U2.2 (AGND), U2.5 (DGND), U2.10 (MD0), U2.11 (MD1), U2.12 (FMT); also elsewhere on the board
unnamed: C3.2, R2.1
unnamed: C4.2, R3.1
unnamed: J1.S, JP17.2 (B)
unnamed: C3.1, J1.R, JP18.1 (A), TP1.1
unnamed: C4.1, J1.T, JP19.2 (B), TP2.1
unnamed: C6.1, R2.2, U2.13 (VINL)
unnamed: C7.1, R3.2, U2.14 (VINR)
VDDA: C12.1, C13.2, U2.3 (VCC); also elsewhere on the board

Notes on the sheet:
Jumper for ground loop mediation
GND and GNDA all the same second layer from the top.
24 Bit ADC
BCK
Data (SD)
Capacitor found necessary in first prototype.
LRCK (WS)

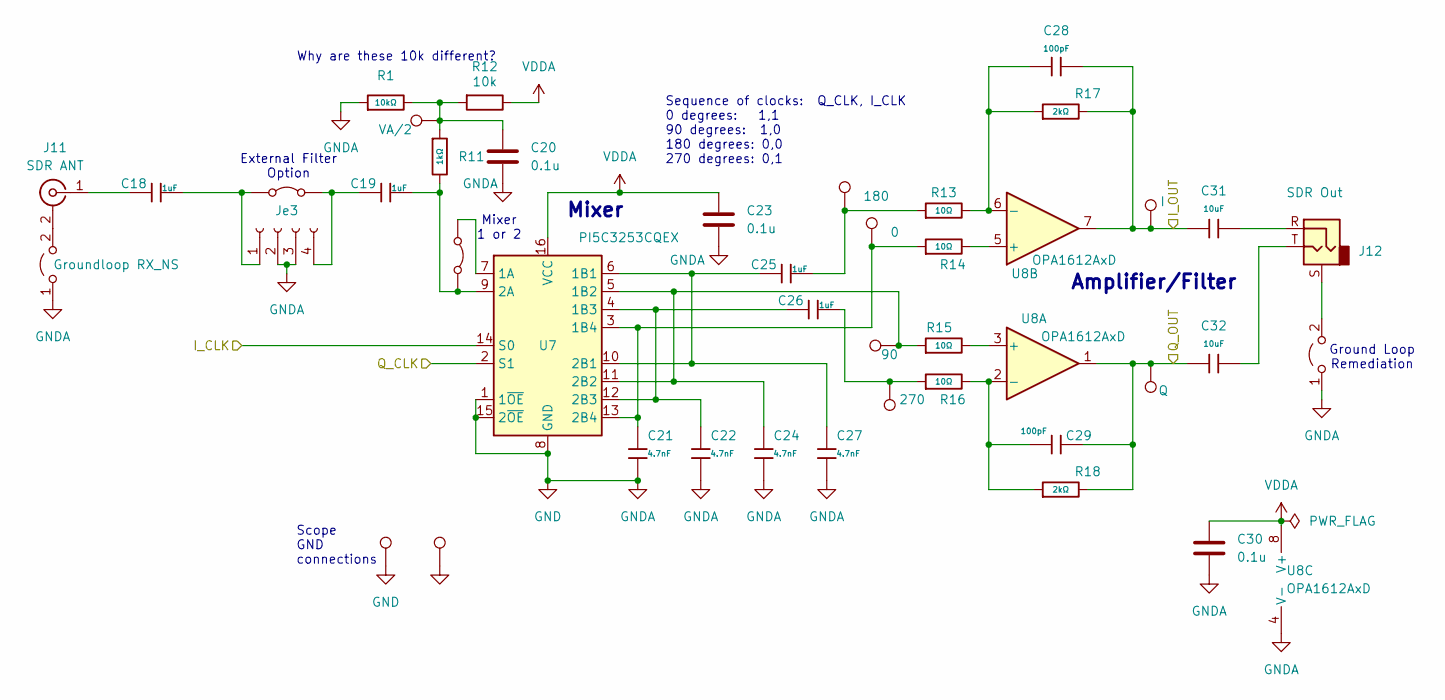
[picture p23: schematic qsd-sdr.kicad_sch, SDR-RX]

Parts:
C18, C19, C25, C26: 1uF; C_0805; Voltage Rated 50V; Tolerance ±10%; Part CL21B105KBFNNNE; LCSC C28323
C20, C23, C30: 0.1u; C_0805_2012Metric; LCSC C49678
C21, C22, C24, C27: 4.7nF; C_0805; Voltage Rated 50V; Tolerance ±10%; Part 0805B472K500NT; LCSC C1744
C28, C29: 100pF; C_0805; Voltage Rated 50V; Tolerance ±5%; Part CL21C101JBANNNC; LCSC C1790
C31, C32: 10uF; C_0805; Voltage Rated 25V; Tolerance ±10%; Part CL21A106KAYNNNE; LCSC C15850
J11: SDR ANT; BNC_TEConnectivity_1478204_Vertical
J12: SDR Out; Jack_3.5mm_CUI_SJ-3523-SMT_Horizontal; LCSC C18594
JP85: Groundloop RX_NS; SolderJumper-2_P1.3mm_Open_RoundedPad1.0x1.5mm
JP86, JP87: Jumper_2_Bridged; SolderJumper-2_P1.3mm_Bridged2Bar_RoundedPad1.0x1.5mm
JP88: GND_LP_SND; SolderJumper-2_P1.3mm_Open_RoundedPad1.0x1.5mm
Je3: Filter; PinHeader_1x04_P2.54mm_Vertical_Female; LCSC C2718488
R1: 10kΩ; R_0603; Overload Voltage (Max) 75V; Tolerance ±1%; Part 0603WAF1002T5E; LCSC C25804
R11: 1kΩ; R_0603; Overload Voltage (Max) 75V; Tolerance ±1%; Part 0603WAF1001T5E; LCSC C21190
R12: 10k; R_0805_2012Metric; LCSC C17414
R13, R14, R15, R16: 10Ω; R_0805; Overload Voltage (Max) 150V; Tolerance ±1%; Part 0805W8F100JT5E; LCSC C17415
R17, R18: 2kΩ; R_0805; Overload Voltage (Max) 150V; Tolerance ±1%; Part 0805W8F2001T5E; LCSC C17604
TP10, TP12: GND; TestPoint_THTPad_D2.0mm_Drill1.0mm
TP11: VA/2; TestPoint_THTPad_D1.0mm_Drill0.5mm
TP13: 180; TestPoint_THTPad_D1.0mm_Drill0.5mm
TP14: 0; TestPoint_THTPad_D1.0mm_Drill0.5mm
TP15: 270; TestPoint_THTPad_D1.0mm_Drill0.5mm
TP16: 90; TestPoint_THTPad_D1.0mm_Drill0.5mm
TP17: I; TestPoint_THTPad_D1.0mm_Drill0.5mm
TP18: Q; TestPoint_THTPad_D1.0mm_Drill0.5mm
U7: PI5C3253CQEX; SSOP-16_3.9x4.9mm_P0.635mm; LCSC C3001703
U8: OPA1612AxD; SOIC-8_3.9x4.9mm_P1.27mm; LCSC C94590

Connections:
/I: C28.2, C31.1, R17.2, TP17.1, U8.7; also elsewhere on the board
/I_CLK: U7.14 (S0); also elsewhere on the board
/Q: C29.2, C32.1, R18.2, TP18.1, U8.1; also elsewhere on the board
/Q_CLK: U7.2 (S1); also elsewhere on the board
GND: C20.1, C21.2, C22.2, C23.1, C24.2, C27.2, C30.1, JP85.1 (A), JP88.1 (A), Je3.2, Je3.3, R1.1, TP10.1, TP12.1, U7.1 (1~OE), U7.8 (GND), U7.15 (2~OE), U8.4 (V-); also elsewhere on the board
unnamed: C20.2, R1.2, R11.1, R12.2, TP11.1
unnamed: C25.2, R13.1, TP13.1
unnamed: C26.2, R16.1, TP15.1
unnamed: C31.2, J12.R
unnamed: C32.2, J12.T
unnamed: J11.2 (Ext), JP85.2 (B)
unnamed: C18.1, J11.1 (In)
unnamed: C18.2, JP86.1 (A), Je3.1
unnamed: C19.1, JP86.2 (B), Je3.4
unnamed: JP87.1 (A), U7.7 (1A)
unnamed: C19.2, JP87.2 (B), R11.2, U7.9 (2A)
unnamed: J12.S, JP88.2 (B)
unnamed: C25.1, C27.1, U7.6 (1B1), U7.10 (2B1)
unnamed: C24.1, R15.1, TP16.1, U7.5 (1B2), U7.11 (2B2)
unnamed: C22.1, C26.1, U7.4 (1B3), U7.12 (2B3)
unnamed: C21.1, R14.1, TP14.1, U7.3 (1B4), U7.13 (2B4)
unnamed: R15.2, U8.3 (+)
unnamed: C29.1, R16.2, R18.1, U8.2 (-)
unnamed: R14.2, U8.5 (+)
unnamed: C28.1, R13.2, R17.1, U8.6 (-)
VDDA: C23.2, C30.2, R12.1, U7.16 (VCC), U8.8 (V+); also elsewhere on the board

Notes on the sheet:
Why are these 10k different?
Sequence of clocks: Q_CLK, I_CLK 0 degrees: 1,1 90 degrees: 1,0 180 degrees: 0,0 270 degrees: 0,1
Amplifier/Filter
Ground Loop Remediation
Mixer
Mixer 1 or 2
Scope GND connections
External Filter Option
