frohro/Raspberry_Pi_Pico_MultiBoard/Hardware/Audio_in_usd_sound_rp_pico.kicad_pcb

## KiCad design Hardware/Audio_in_usd_sound_rp_pico.kicad_pcb (continued)

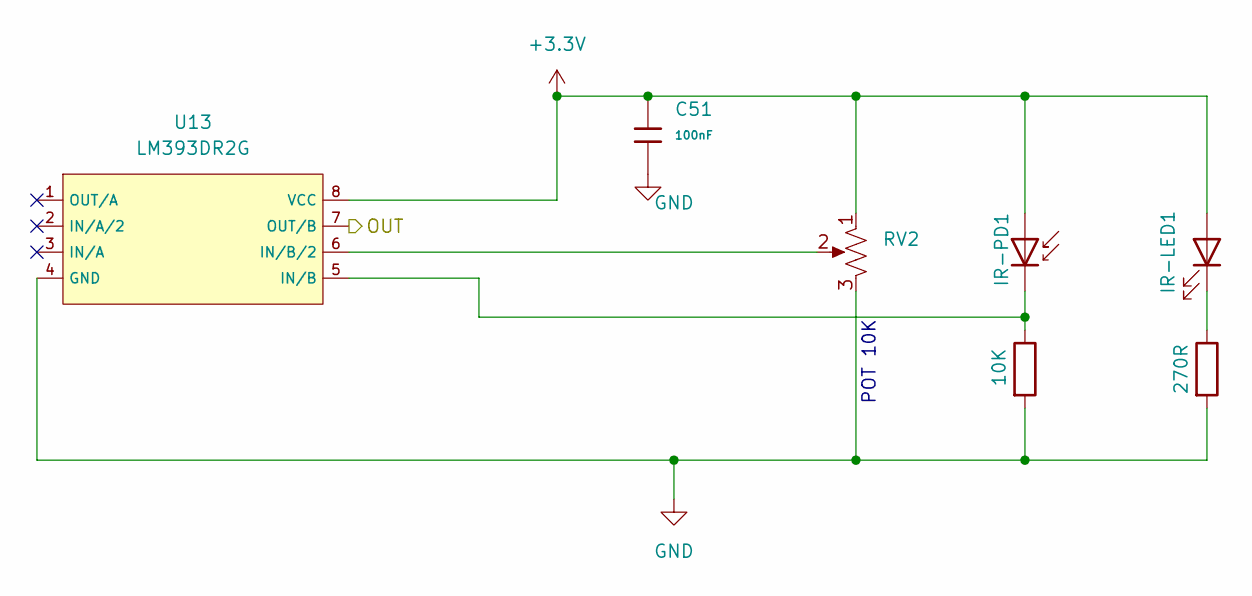
[picture p24: schematic Proximity Sensing.kicad_sch]

Parts:
C51: 100nF; C_0805; Voltage Rated 50V; Tolerance ±10%; Part CC0805KRX7R9BB104; LCSC C49678
IR-LED1: IR26-21C_L110_TR8; LED_1206_3216Metric; LCSC C965892
IR-PD1: D_Photo; LED_D5.0mm; LCSC C965891
R35: 10K; R_0805_2012Metric; Part # C17414
R36: 270R; R_0805_2012Metric; Part # 0805W8F1002T5E
RV2: R_Potentiometer_US; Potentiometer_Piher_PT-6-V_Vertical_Hole
U13: LM393DR2G; SOIC-8_L5.0-W4.0-P1.27-LS6.0-BL; Supply Voltage 2V~36V;1V~18V; Part LM393DR2G; LCSC C7955

Connections:
+3.3V: C51.1, IR-LED1.2 (A), IR-PD1.2 (A), RV2.1, U13.8 (VCC); also elsewhere on the board
/PROX: U13.7 (OUT/B); also elsewhere on the board
GND: C51.2, R35.2, R36.2, RV2.3, U13.4 (GND); also elsewhere on the board
unnamed: IR-LED1.1 (K), R36.1
unnamed: IR-PD1.1 (K), R35.1, U13.5 (IN/B)
unnamed: RV2.2, U13.6 (IN/B/2)

Notes on the sheet:
POT 10K

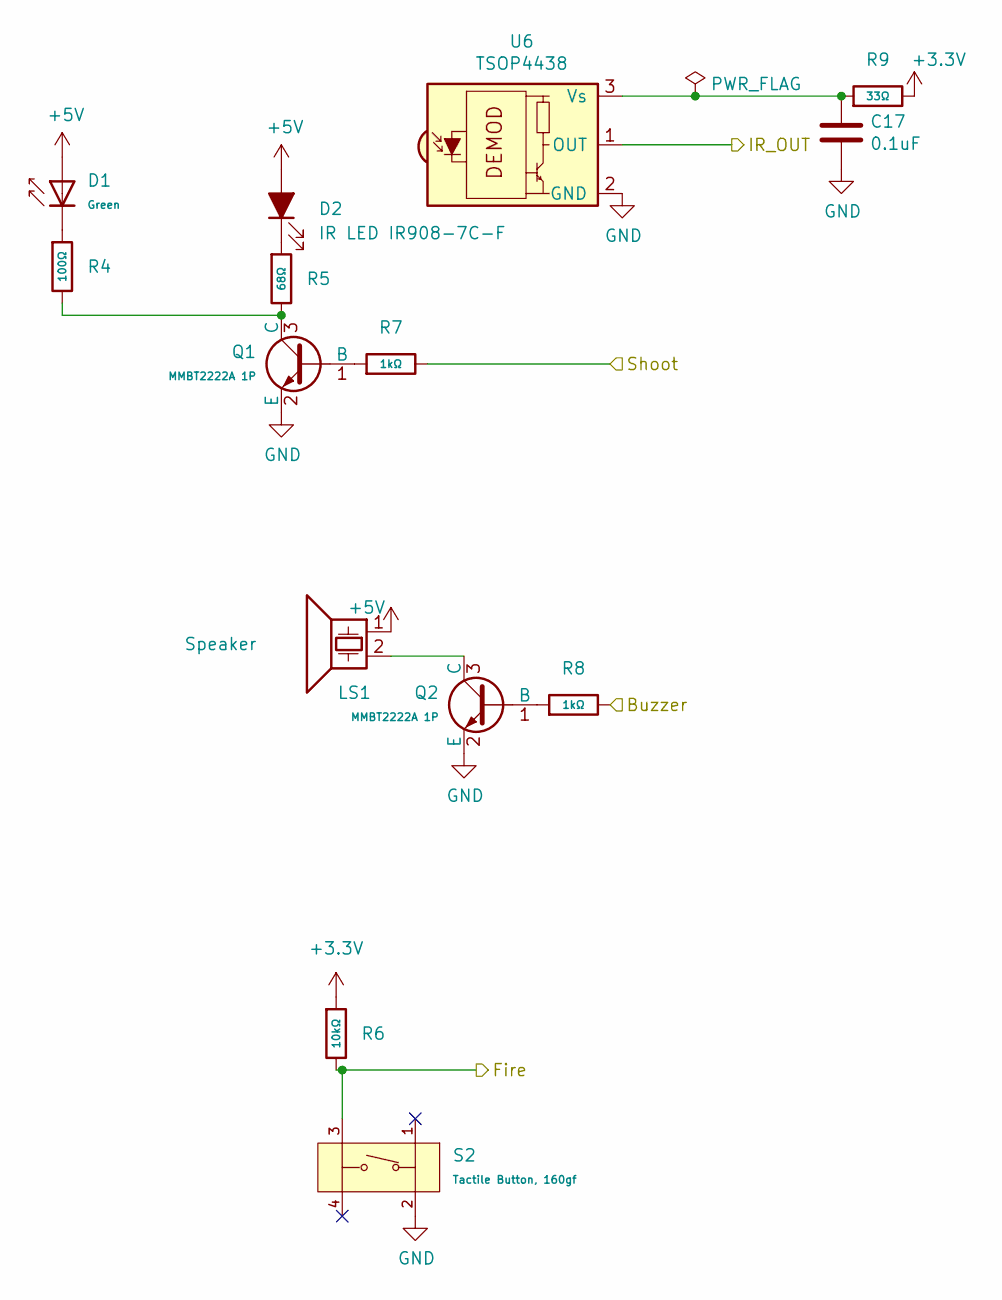
[picture p25: schematic lasertag.kicad_sch, Laser Tag]

Parts:
C17: 0.1uF; C_0805_2012Metric
D1: Green; D_0805; Part KT-0805G; LCSC C2297
D2: IR LED IR908-7C-F; LED_D1.8mm_W1.8mm_H2.4mm_Horizontal_O1.27mm_Z8.2mm; LCSC C183794
LS1: Speaker; Buzzer_12x9.5RM7.6; LCSC C409842
Q1, Q2: MMBT2222A 1P; Q_SOT-23; Part MMBT2222A 1P; LCSC C8512
R4: 100Ω; R_0805; Overload Voltage (Max) 150V; Tolerance ±1%; Part 0805W8F1000T5E; LCSC C17408
R5: 68Ω; R_0805; Overload Voltage (Max) 150V; Tolerance ±1%; Part 0805W8F680JT5E; LCSC C17802
R6: 10kΩ; R_0805; Overload Voltage (Max) 150V; Tolerance ±1%; Part 0805W8F1002T5E; LCSC C17414
R7, R8: 1kΩ; R_0805; Overload Voltage (Max) 150V; Tolerance ±1%; Part 0805W8F1001T5E; LCSC C17513
R9: 33Ω; R_0805; Overload Voltage (Max) 150V; Tolerance ±1%; Part 0805W8F330JT5E; LCSC C17634
S2: Tactile Button, 160gf; SW-SMD_4P-L5.1-W5.1-P3.70-LS6.5-TL-2; Voltage Rating (Dc) 12V; Part TS-1187A-B-A-B; LCSC C318884
U6: TSOP4438; Vishay_MOLD-3Pin; LCSC C124647

Connections:
+3.3V: R6.1, R9.2; also elsewhere on the board
+5V: D1.2, D2.2 (A), LS1.1; also elsewhere on the board
/Buzzer: R8.2; also elsewhere on the board
/Fire: R6.2, S2.3 (C); also elsewhere on the board
/IR_OUT: U6.1 (OUT); also elsewhere on the board
/Shoot: R7.2; also elsewhere on the board
GND: C17.2, Q1.2 (E), Q2.2 (E), S2.2 (B), U6.2 (GND); also elsewhere on the board
unnamed: D1.1, R4.1
unnamed: D2.1 (K), R5.1
unnamed: Q1.1 (B), R7.1
unnamed: Q1.3 (C), R4.2, R5.2
unnamed: Q2.1 (B), R8.1
unnamed: LS1.2, Q2.3 (C)
unnamed: C17.1, R9.1, U6.3 (Vs)

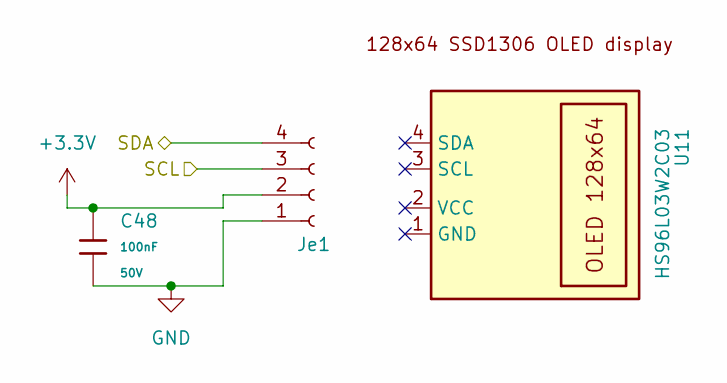
[picture p26: schematic OLED.kicad_sch, OLED Display]

Parts:
C48: 100nF; C_0603; Voltage Rated 50V; Tolerance ±10%; Part CC0603KRX7R9BB104; LCSC C14663
Je1: Conn_01x04_Socket; PinHeader_1x04_P2.54mm_Vertical_Female; LCSC C2718488
U11: HS96L03W2C03; OLED; LCSC C5248080

Connections:
+3.3V: C48.1, Je1.2; also elsewhere on the board
/SCL: Je1.3; also elsewhere on the board
/SDA: Je1.4; also elsewhere on the board
GND: C48.2, Je1.1; also elsewhere on the board

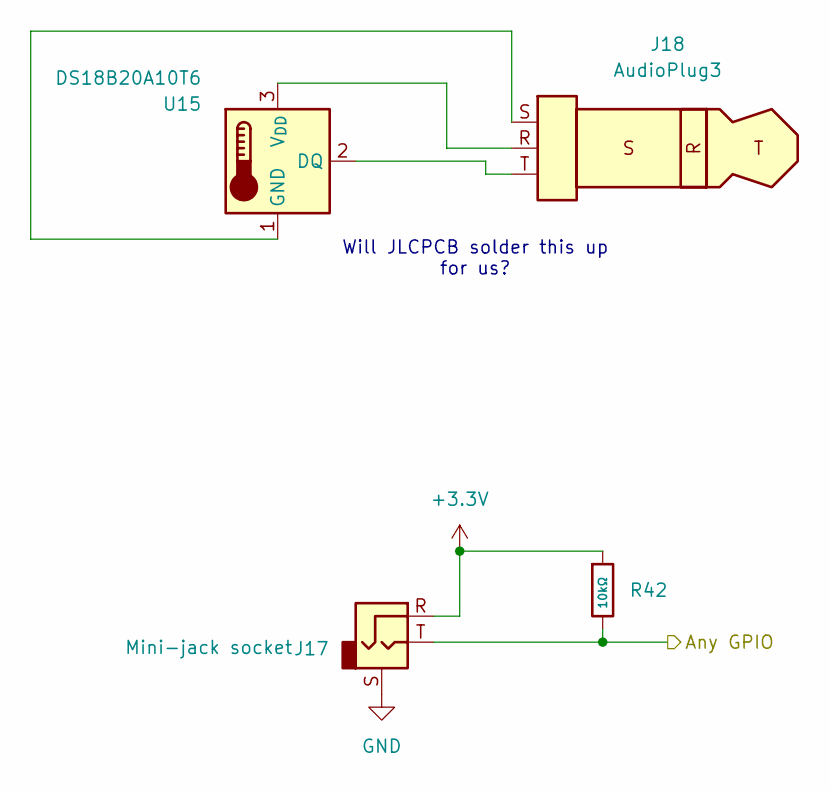
[picture p27: schematic thermometer.kicad_sch]

Parts:
J17: Mini-jack socket; Jack_3.5mm_CUI_SJ-3523-SMT_Horizontal; LCSC C18594
J18: AudioPlug3
R42: 10kΩ; R_0805; Overload Voltage (Max) 150V; Tolerance ±1%; Part 0805W8F1002T5E; LCSC C17414
U15: DS18B20A10T6; TO-92_Inline; LCSC C22360667

Connections:
+3.3V: J17.R, R42.1; also elsewhere on the board
/Therm: J17.T, R42.2; also elsewhere on the board
GND: J17.S; also elsewhere on the board
unnamed: J18.T, U15.2 (DQ)
unnamed: J18.S, U15.1 (GND)
unnamed: J18.R, U15.3 (V_{DD})

Notes on the sheet:
Will JLCPCB solder this up for us?

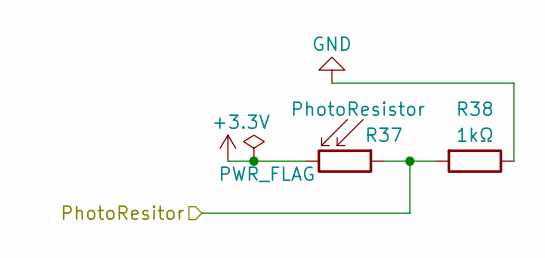
[picture p28: schematic photo_resistor.kicad_sch]

Parts:
R37: PhotoResistor; R_LDR_5.1x4.3mm_P3.4mm_Vertical; JLCPCB Part # C10077
R38: 1kΩ; R_1206_3216Metric; JLCPCB Part # C17902

Connections:
+3.3V: R37.2; also elsewhere on the board
/PHOTO: R37.1, R38.2; also elsewhere on the board
GND: R38.1; also elsewhere on the board

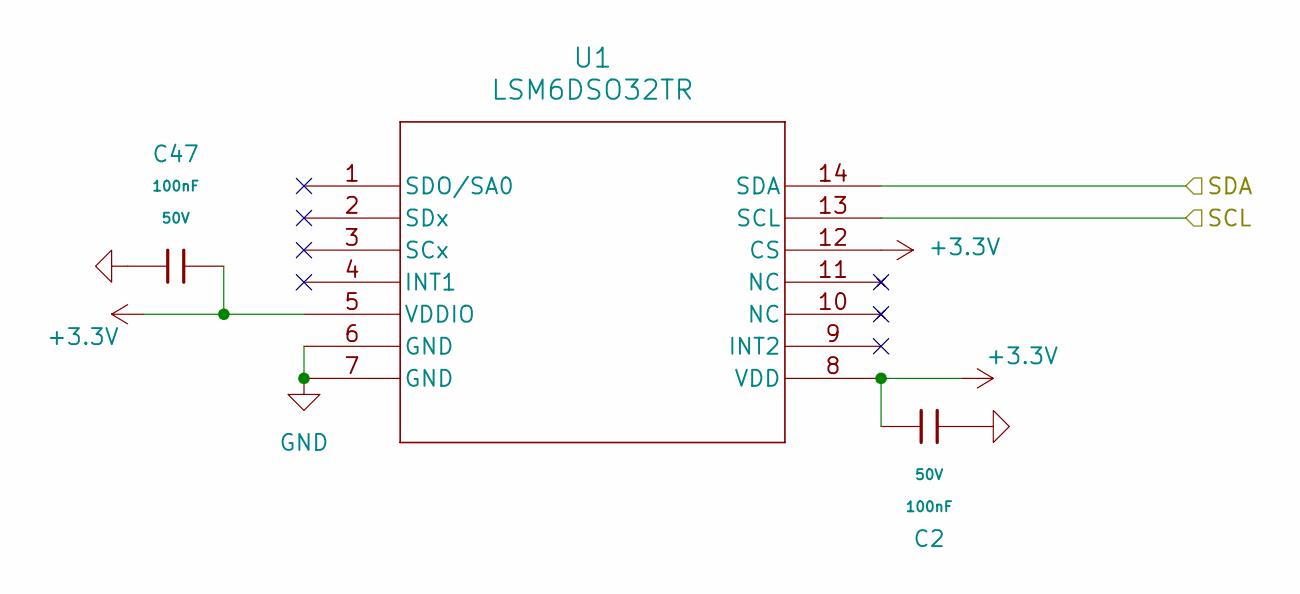
[picture p29: schematic Accelerometer.kicad_sch, MPU 6050 Accelerometer]

Parts:
C2, C47: 100nF; C_0603; Voltage Rated 50V; Tolerance ±10%; Part CC0603KRX7R9BB104; LCSC C14663
U1: LSM6DSO32TR; LGA-14L_2P5X3X0P83_STM

Connections:
+3.3V: C2.2, C47.2, U1.5 (VDDIO), U1.8 (VDD), U1.12 (CS); also elsewhere on the board
/SCL: U1.13 (SCL); also elsewhere on the board
/SDA: U1.14 (SDA); also elsewhere on the board
GND: C2.1, C47.1, U1.6 (GND), U1.7 (GND); also elsewhere on the board

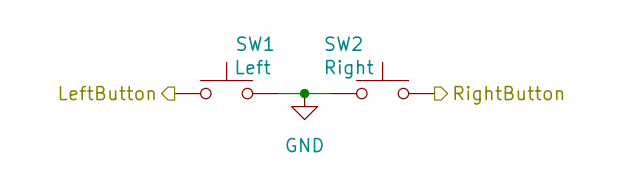
[picture p30: schematic Left_Right_Buttons.kicad_sch, Left and Right Buttons]

Parts:
SW1: Left; SW-SMD_4P-L5.1-W5.1-P3.70-LS6.5-TL-2; LCSC C318884
SW2: Right; SW-SMD_4P-L5.1-W5.1-P3.70-LS6.5-TL-2; LCSC C318884

Connections:
/LeftButton: SW1.1; also elsewhere on the board
/RightButton: SW2.2; also elsewhere on the board
GND: SW1.2, SW2.1; also elsewhere on the board

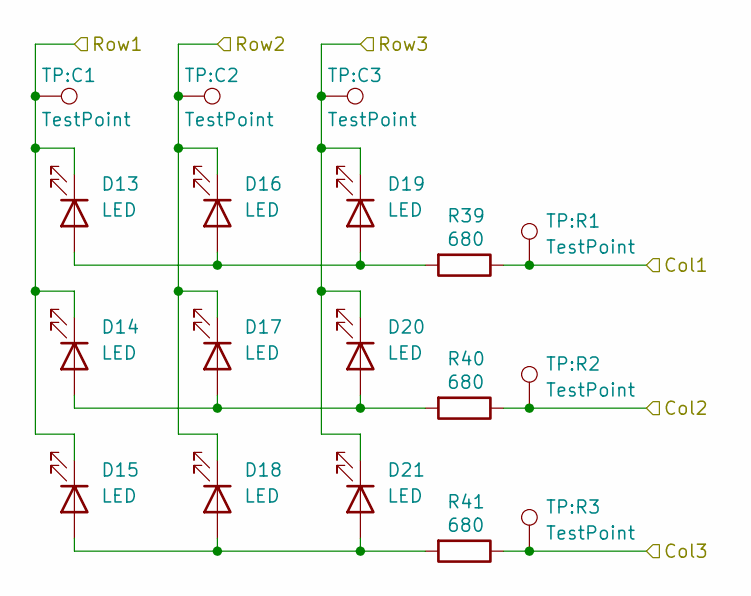
[picture p31: schematic LED_Matrix.kicad_sch, 3X3 LED Matrix]

Parts:
D13, D14, D15, D16, D17, D18, D19, D20, D21: LED; LED_0805_2012Metric; LCSC C84256
R39, R40, R41: 680; R_0805_2012Metric; LCSC C17798
TP:C1, TP:C2, TP:C3: TestPoint; TestPoint_THTPad_D1.0mm_Drill0.5mm
TP:R1, TP:R2, TP:R3: TestPoint; TestPoint_THTPad_D1.0mm_Drill0.5mm

Connections:
/MatrixC1: R39.1, TP:R1.1; also elsewhere on the board
/MatrixC2: R40.1, TP:R2.1; also elsewhere on the board
/MatrixC3: R41.1, TP:R3.1; also elsewhere on the board
/MatrixR1: D13.1 (K), D14.1 (K), D15.1 (K), TP:C1.1; also elsewhere on the board
/MatrixR2: D16.1 (K), D17.1 (K), D18.1 (K), TP:C2.1; also elsewhere on the board
/MatrixR3: D19.1 (K), D20.1 (K), D21.1 (K), TP:C3.1; also elsewhere on the board
unnamed: D13.2 (A), D16.2 (A), D19.2 (A), R39.2
unnamed: D14.2 (A), D17.2 (A), D20.2 (A), R40.2
unnamed: D15.2 (A), D18.2 (A), D21.2 (A), R41.2

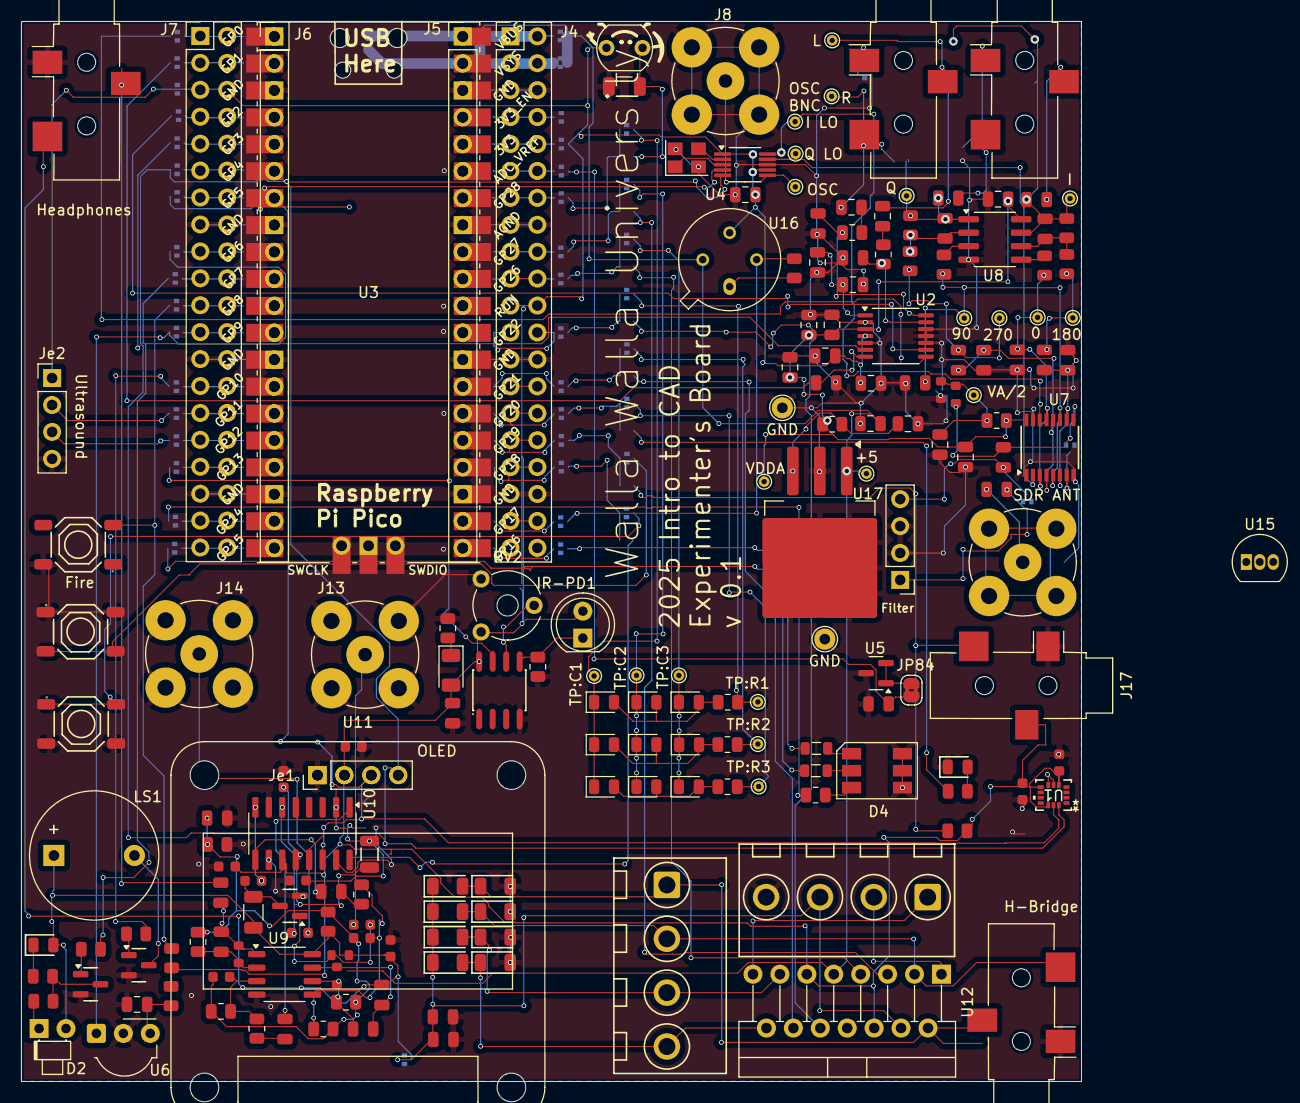
[picture p32: board Audio_in_usd_sound_rp_pico.kicad_pcb from above]

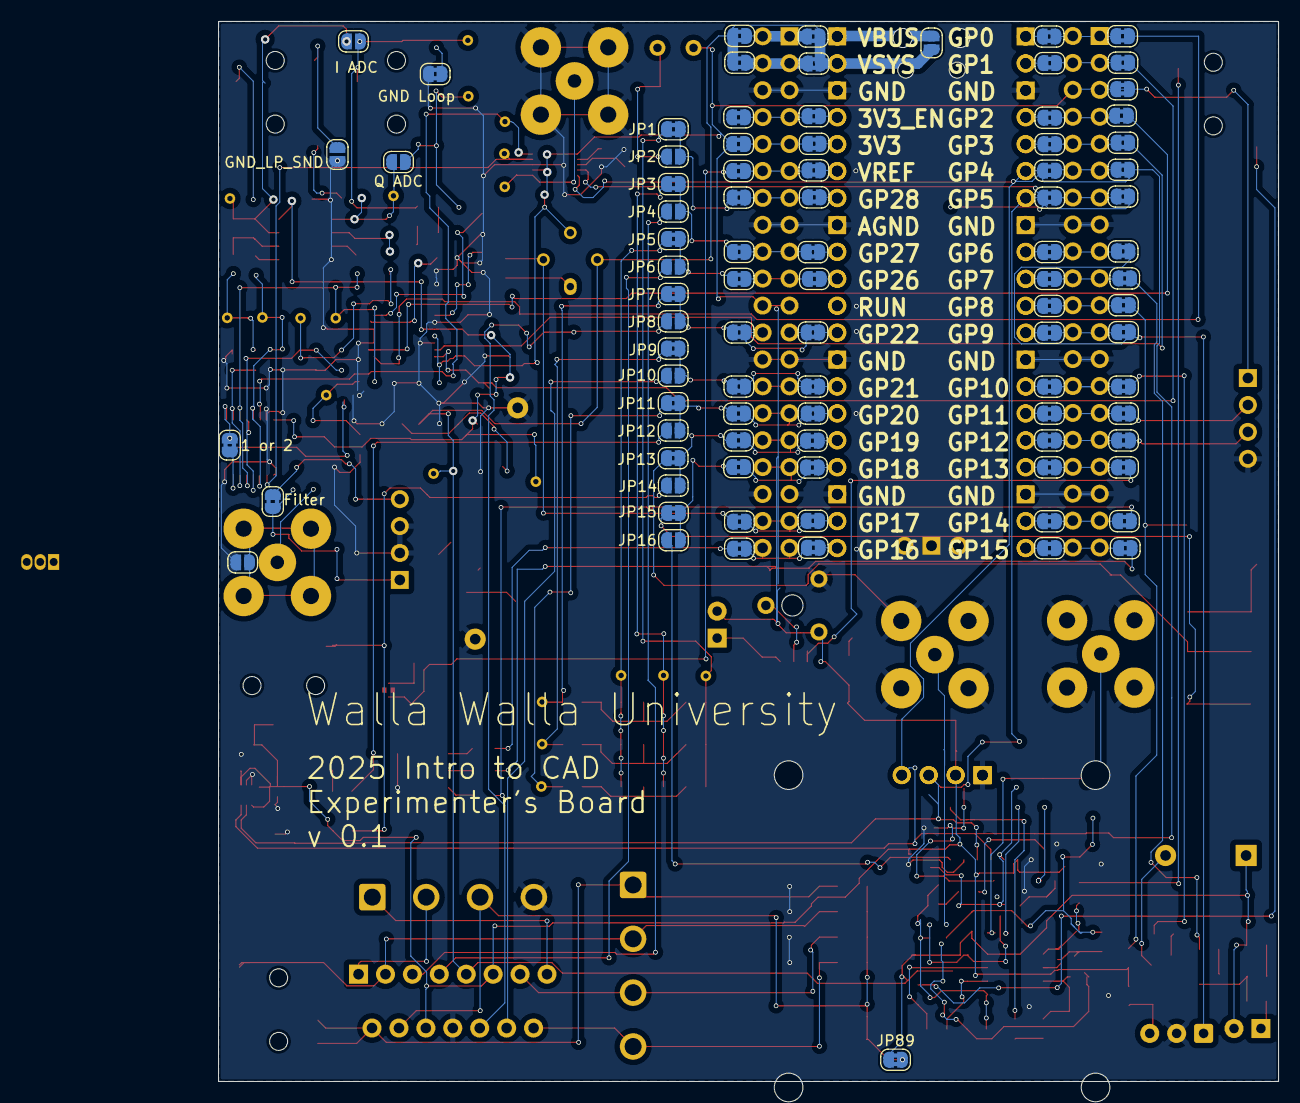
[picture p33: board Audio_in_usd_sound_rp_pico.kicad_pcb from below]

Board: 2 copper layers, 100.0 x 100.0 mm, 275 parts (88 on the bottom side), 189 nets.
