frohro/Raspberry_Pi_Pico_MultiBoard/(commit log)

2025-04-10 Initial commit with complete project structure.!
    [Accelerometer.kicad_sch, Amphenol RF 122404.STEP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]
2025-04-10 Changed to SoftI2C, because hardware I2C doesn't seem to work
    [si5351.py, test_SoftI2C.py, test_i2c.py]
2025-04-29 Hardware errors found.
    [Audio_in_usd_sound_rp_pico.kicad_pcb, audio.kicad_sch, qsd-sdr.kicad_sch]
2025-04-29 Finding bugs in Si4732, etc.
    [i2cScanner.py, si5351.py]
2025-05-23 Update README with details about Pico clone power supply differences and remove obsolete KiCad lock file
2025-05-23 Add details about Pico power supply schematic and Si5351a test observations in README
2025-05-23 Update README to clarify Si5351a test results with additional board information
